K7MDL2/RF-Power-Meter-V1/Pictures/Teensy 4.1 Wattmeter and Band Decoder Combo Build PinOut Chart.jpg

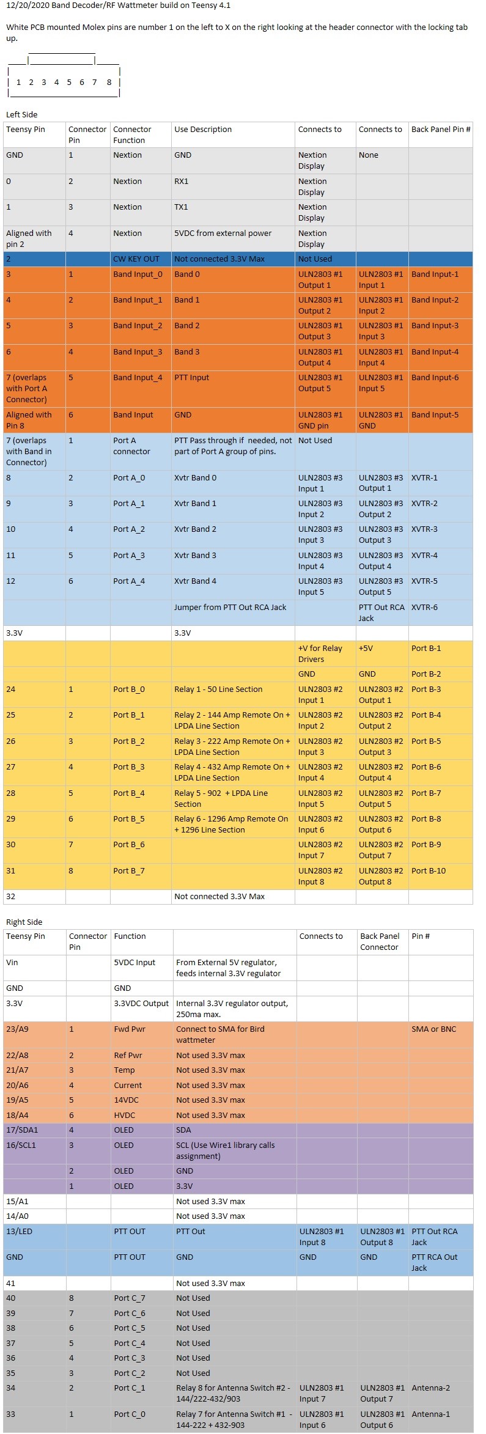
Pictures/Teensy 4.1 Wattmeter and Band Decoder Combo Build PinOut Chart.jpg
