K7MDL2/RF-Power-Meter-V1/Pictures/Teensy 4.1 Band Decoder-Wattmeter CPU board connectorization.jpg

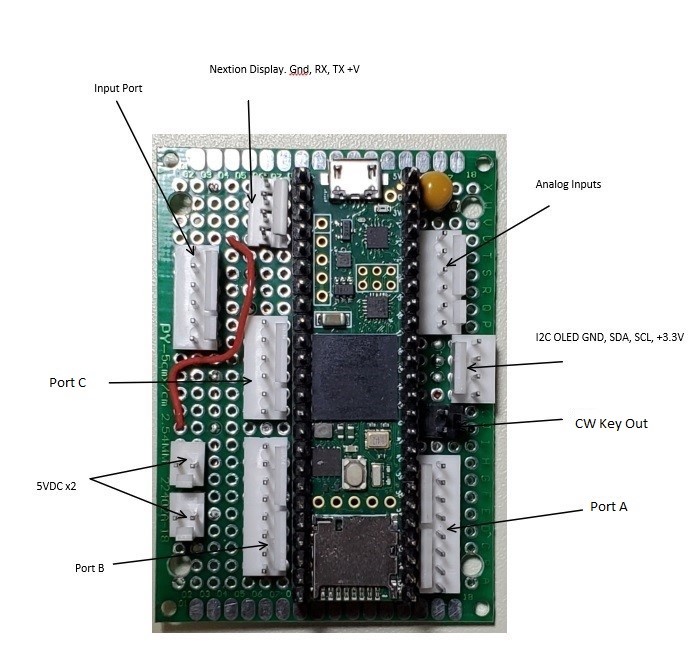
Pictures/Teensy 4.1 Band Decoder-Wattmeter CPU board connectorization.jpg
