K7MDL2/RF-Power-Meter-V1/RF_Wattmeter_Teensy41_PCB_V1/Docs/Teensy 4.1 RF Wattmeter and Band Decoder Project.pptx

## HF-10GHz RF Wattmeter & Band Decoder DRAFT 4/11/2022

By Mike Lewis, K7MDL
Use surplus dual-directional couplers for accurate power measurements using PSoc5LP or Arduino CPU local, or remote over ethernet

## Slide 2

RF Wattmeter portion

RF power forward and reflected
Calculate SWR
Option to output a voltage proportional to SWR for amplifier high SWR protection
Operate either remote over ethernet or local via USB
Operate headless or with a small OLED or a 2.4” or 3.5” Nextion intelligent display
Nextion display has several pages include a SWR chart and calibration, settings
Optional Python Desktop app to monitor power., voltage, current and temp.
Can also change bands and control a headless Arduino Rotator

## Slide 3

Hardware

Custom PCB designed for RFI resistance and no wires (antennas!), and board edge connectors.
ADL5519 dual 10GHz rated log power detector module from SV1AFN
Has about a 60dB usable range
ADS1115 4 cha 16bit ADC with onboard precision voltage refence and programmable PGA
Common online part
Front panel
Power switch and LED
Ethernet jack
Optional displays
Host USB2 port (future use)
Teensy USB connector
Input port on DB9 female connector using Opto-Couplers
6x lines for band selection along
PTT input line
Output Ports on Stacked female D-Sub 15 pin connectors, uses Opto-Couplers
Port A - 8-lines, PTT1 output, low current 12V
Port B - 8-lines, PTT2 output, low current 12V
2 separate PTT outputs, PTT1 and PTT2
Both tied together in software today, can be separated for sequencing with minor coding
One on each output port connector
PTT1 is also presented on a RCA jack
12V powered via coaxial DC power jack

## Slide 4

PCB features

Sized to slides into a common metal case from online
Choice of 2 displays, if any used
PCB designed to be RFI resistant.
Opto-Couplers on all input and output ports
Very short lines from the connectors to minimize RF radiation inside the box
Only wires are from the PCB to a display if used, all are filtered
Input lines to optocoupler bypassed
12V Power and Display power lines filtered
OLED i2c SCL an SDA data lines are also filtered
Choice of 12V to 5V power – 7805 or DC-DC converters such as LC78_05-3.0, or isolated converters
Pico fuse soldered in.
Diode reverse polarity protection
Mounting holes if slide-in case not used.
Extra mounting holes in middle for mounting daughter cards on standoffs for future stuff
2 pin connector on the switched 12V for optional external watchdog power interrupt
2x Watchdog output lines (WD1 and WD2)
Using Teensy 4 internal watchdog timer that can also trigger one the 2 WD lines
12V and %v aux power connectors
4x analog sensor inputs with voltage dividers or current limit resistors.
Software labels set to assume one is HV (high voltage) such as 28 or 50V
1 input can be set up to measure PCB 12V or an external voltage
1 is current
1 is wired to the ADL5519 onboard temp sensor.
Could be used for temp correction for even greater accuracy

## Slide 5

Programmable

Highly flexible configuration using the desktop app
BCD, 1 of 8, or custom pattern modes for input and output ports
Custom patterns allow for mixing devices such as
Transverters
Remote amp enable
Antenna switches
RF detector coax switch for coupler selection
PTT input and output polarity selection
PTT can be routed to any output put port or ports
enables PTT to specific amp
enable specific transverter
N1MM OTRSP serial control for CW, T/R and band select
2 point RF coupler calibration
Measure with a high and low power to compute slope and intercept points.
10 bands today – each has cal data and custom patterns
Can display microwave band labels (10G, 2.4G, 1296, 24G)

## Slide 6

K7MDL2/RF-Power-Meter-V1: RF wattmeter and Band Decoder on Arduino or PSoC5 modules with Python desktop monitoring and control app. Remote operation via USB Serial or Ethernet (new). (github.com) (https://github.com/K7MDL2/RF-Power-Meter-V1)
