K7MDL2/RF-Power-Meter-V1/Pictures/3.5in RF Wattmeter with Band Decoder.jpg

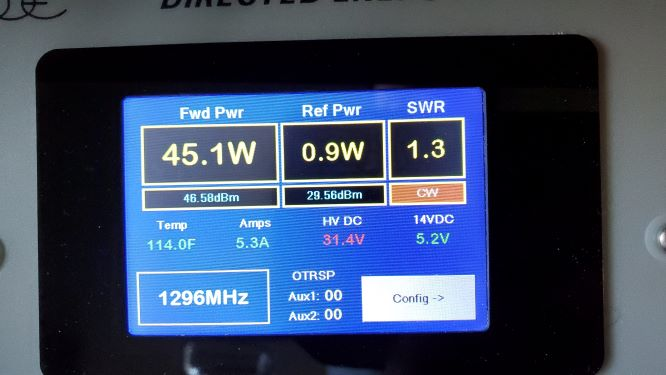
Pictures/3.5in RF Wattmeter with Band Decoder.jpg
