K7MDL2/RF-Power-Meter-V1/Pictures/1296MHz Amplifier Front Panel with OLED RF Wattmeter Mounted.jpg

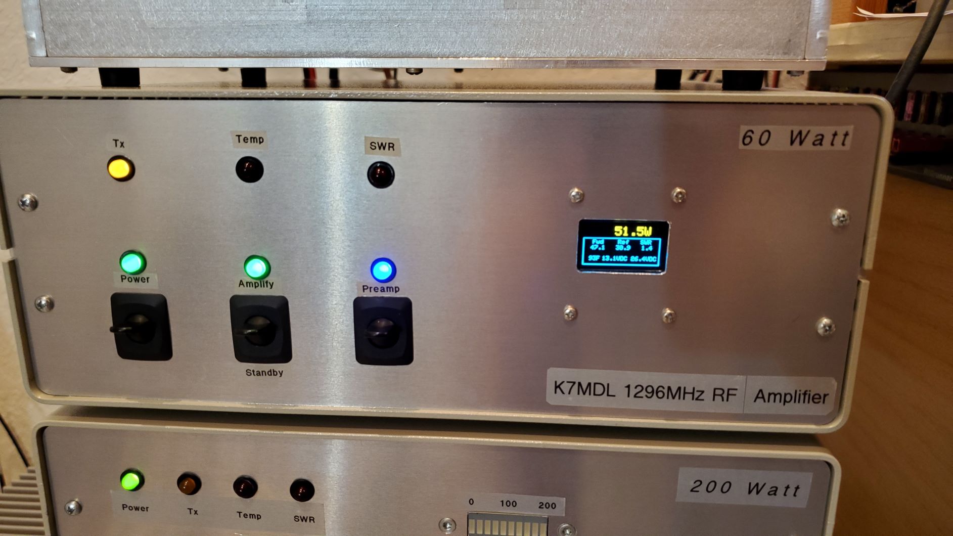
Pictures/1296MHz Amplifier Front Panel with OLED RF Wattmeter Mounted.jpg
