K7MDL2/RF-Power-Meter-V1/Pictures/BandDecoderWattmeter_PCB_V1_Bottom.jpg

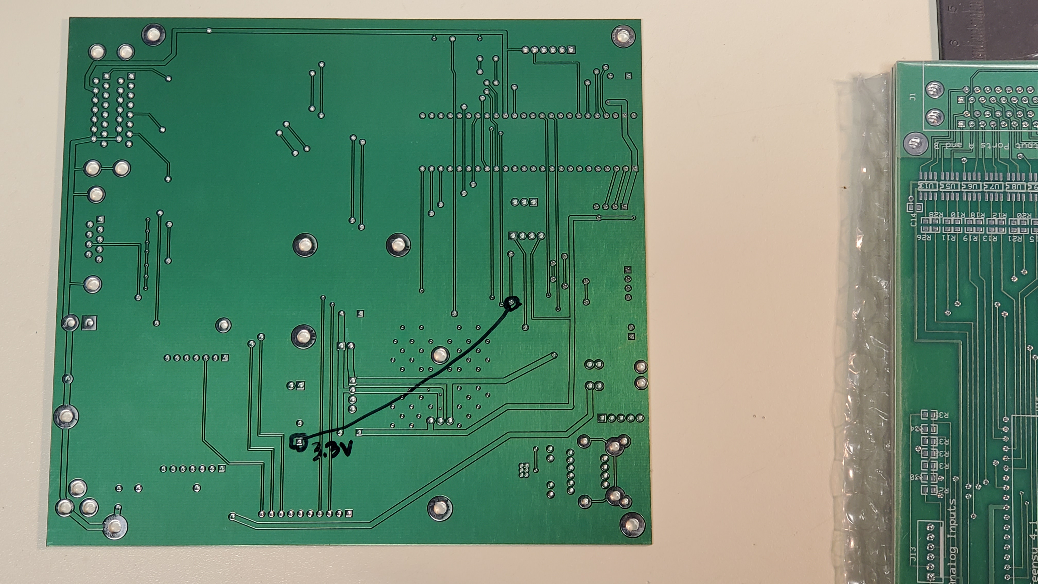
Pictures/BandDecoderWattmeter_PCB_V1_Bottom.jpg
