K7MDL2/RF-Power-Meter-V1/Pictures/Desktop Configuration Page Screen Shot.JPG

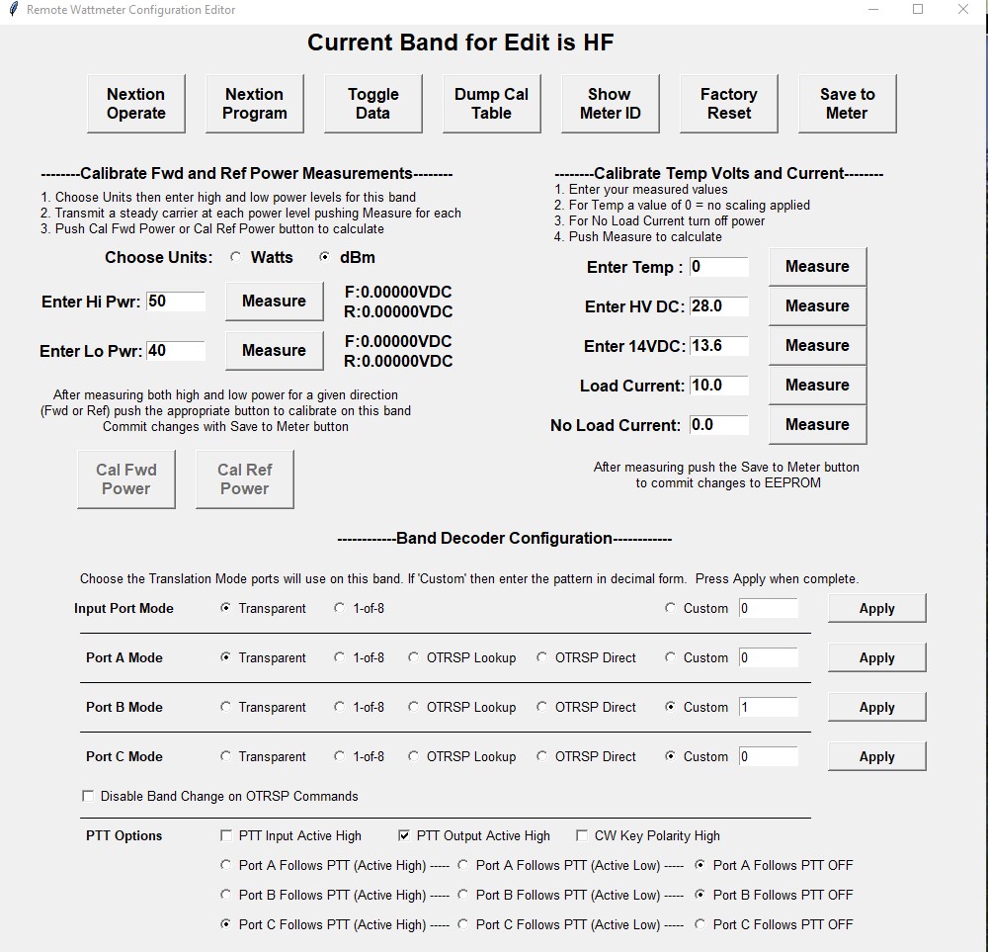
Pictures/Desktop Configuration Page Screen Shot.JPG
