K7MDL2/RF-Power-Meter-V1/Pictures/Edit Meter Table Screen Shot.JPG

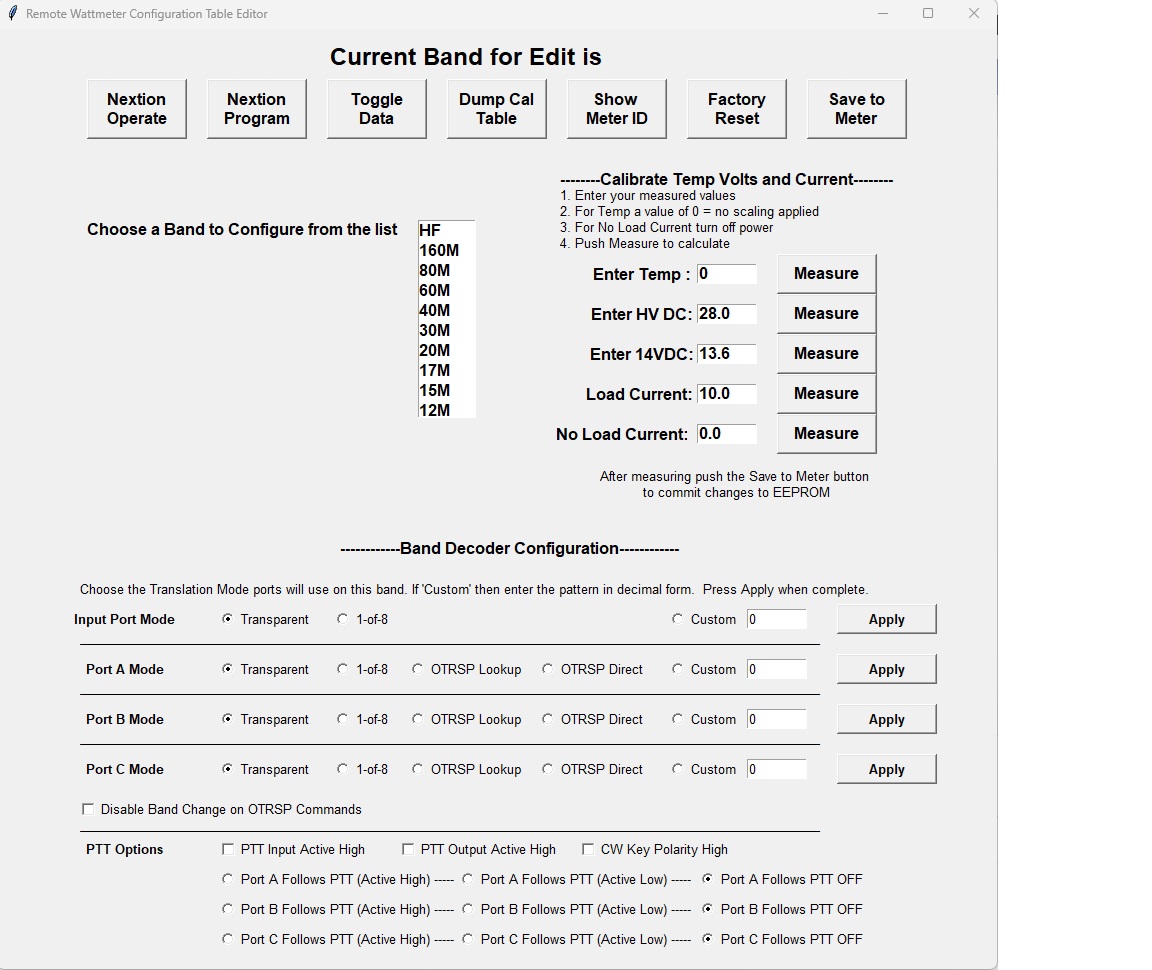
Pictures/Edit Meter Table Screen Shot.JPG
