K7MDL2/RF-Power-Meter-V1/Pictures/Finished Rotor  Controller Side.jpg

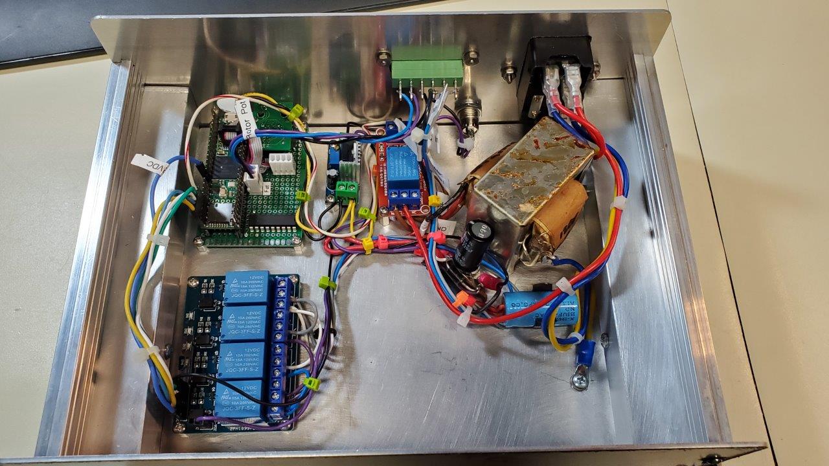
Pictures/Finished Rotor Controller Side.jpg
