K7MDL2/RF-Power-Meter-V1/Pictures/K7MDL 2.4 inch PSoC LCD Main Page.jpg

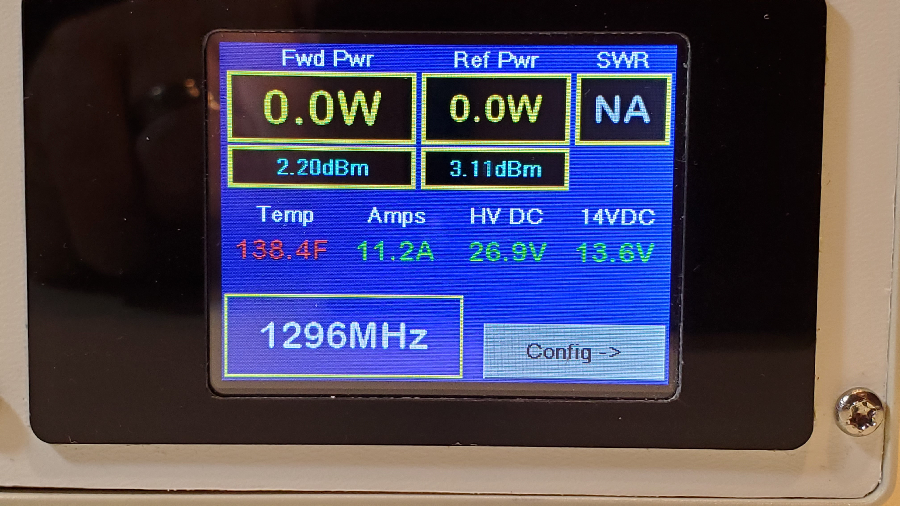
Pictures/K7MDL 2.4 inch PSoC LCD Main Page.jpg
