K7MDL2/RF-Power-Meter-V1/Pictures/K7MDL 2.4inch PSoC RF Meter.jpg

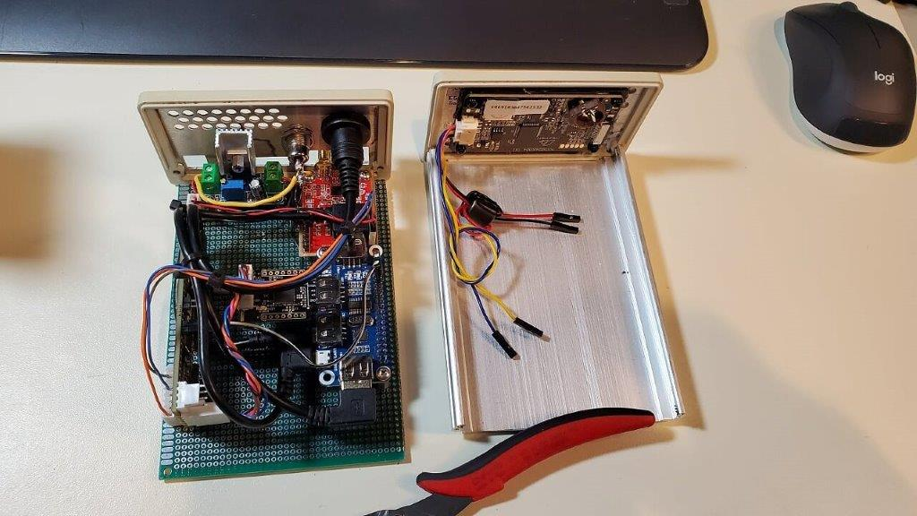
Pictures/K7MDL 2.4inch PSoC RF Meter.jpg
