K7MDL2/RF-Power-Meter-V1/Pictures/K7MDL RF Power Detector.jpg

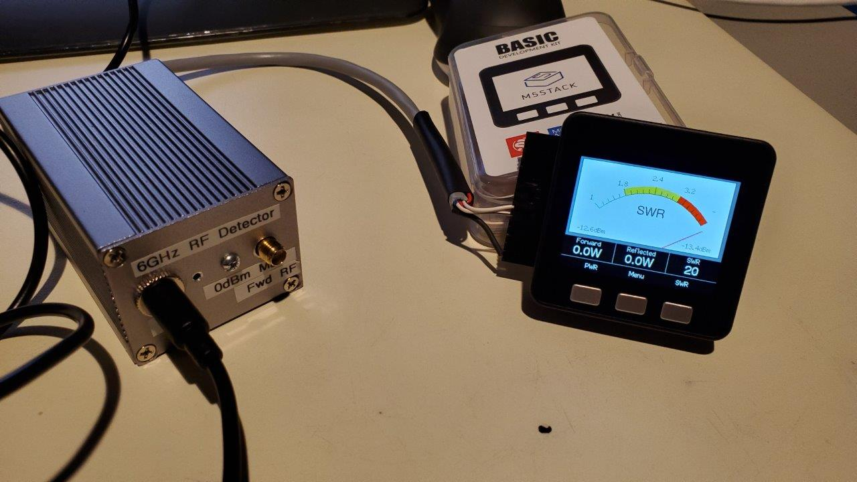
Pictures/K7MDL RF Power Detector.jpg
