K7MDL2/RF-Power-Meter-V1/Pictures/New May 2024  Edit Meter Config Screen Shot.JPG

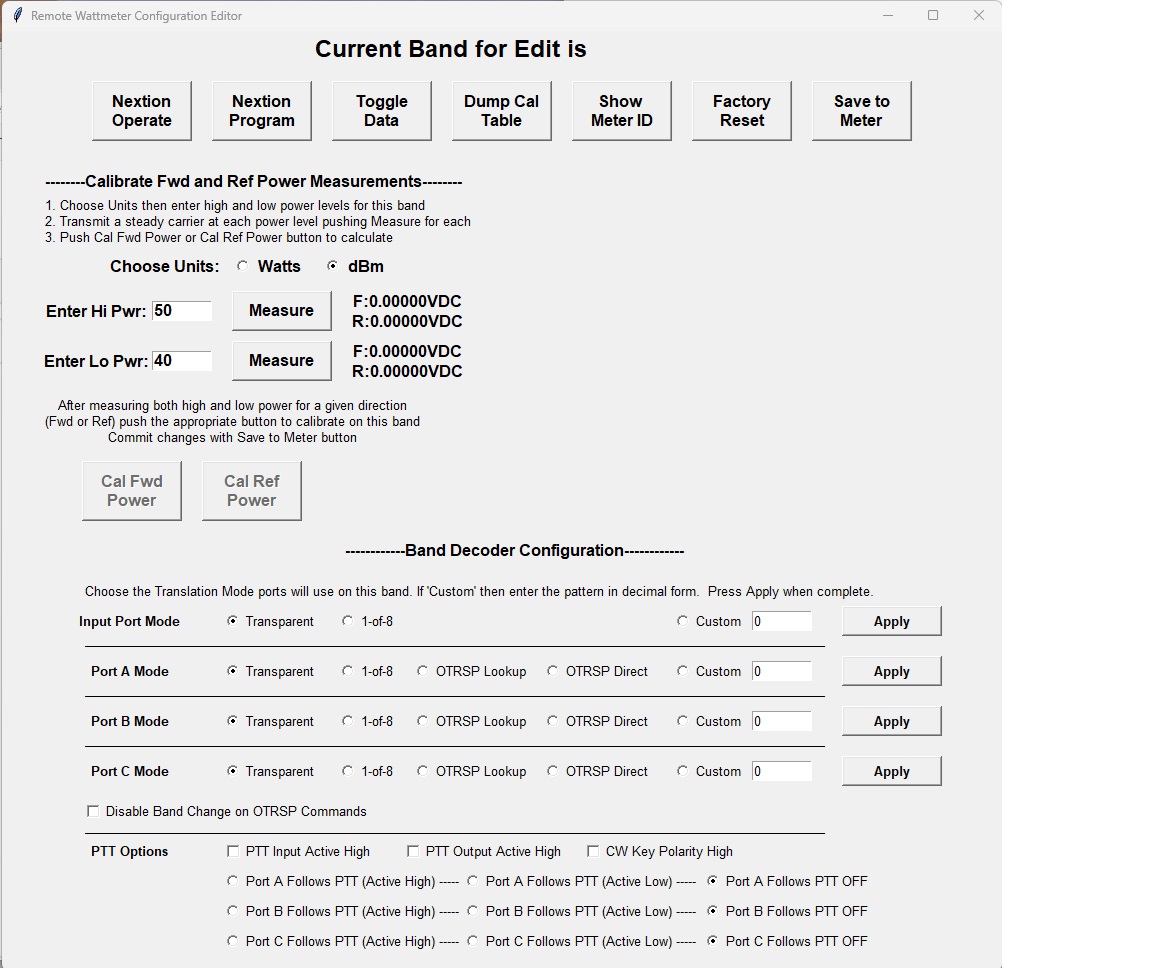
Pictures/New May 2024 Edit Meter Config Screen Shot.JPG
