K7MDL2/RF-Power-Meter-V1/Pictures/OLED Power and Band Decoder Combo screen.jpg

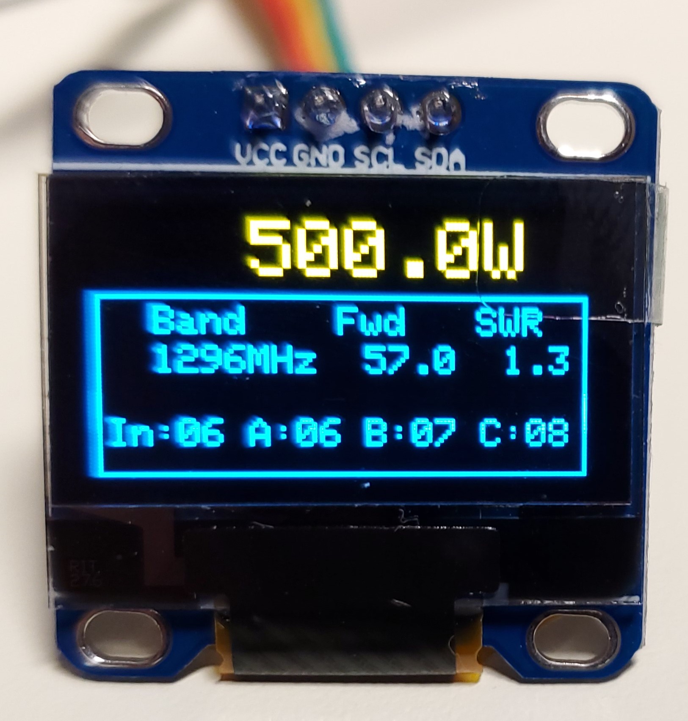
Pictures/OLED Power and Band Decoder Combo screen.jpg
