K7MDL2/RF-Power-Meter-V1/Pictures/Remote Band Decoder Front Panel.jpg

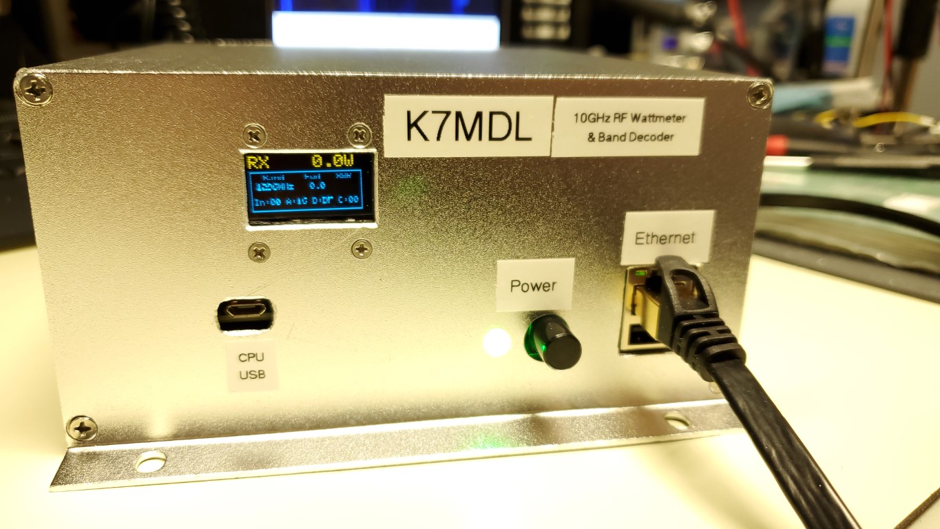
Pictures/Remote Band Decoder Front Panel.jpg
