K7MDL2/RF-Power-Meter-V1/Pictures/Remote Band Decoder Rear Panel.jpg

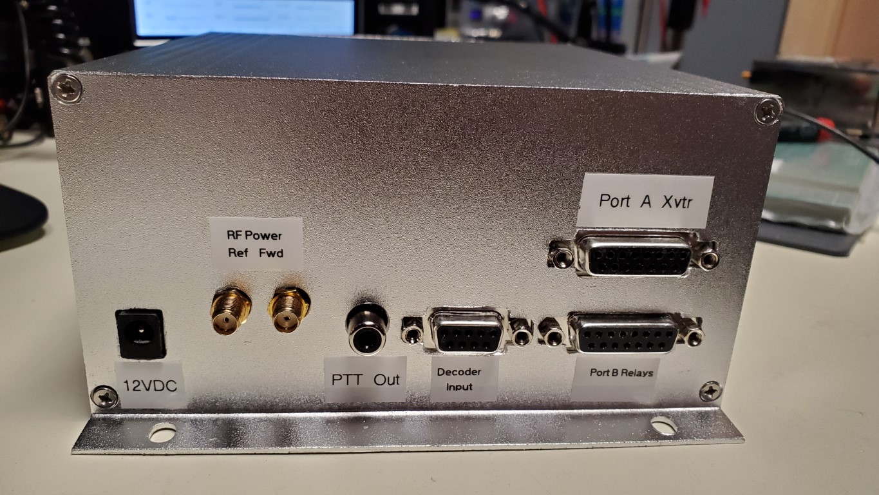
Pictures/Remote Band Decoder Rear Panel.jpg
