K7MDL2/RF-Power-Meter-V1/RF_Meter_PSoC5LP/Amp and Antenna Selection Page.JPG

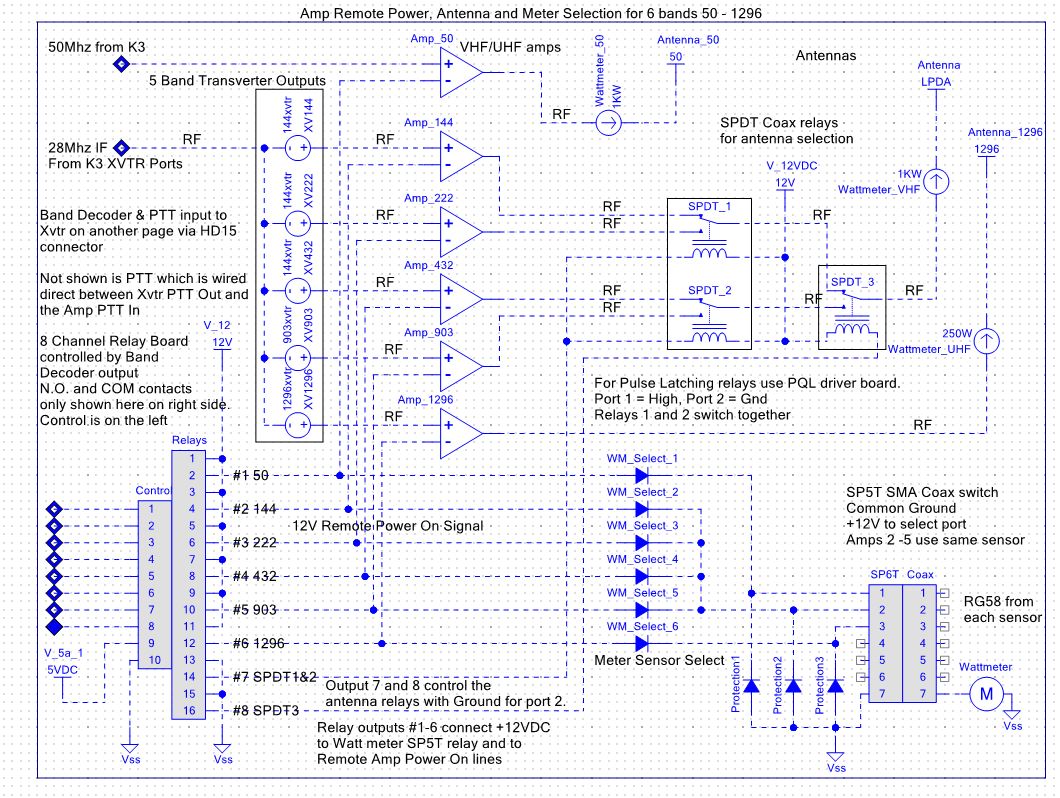
RF_Meter_PSoC5LP/Amp and Antenna Selection Page.JPG
