K7MDL2/RF-Power-Meter-V1/RF_Meter_PSoC5LP/Band Decoder Page.JPG

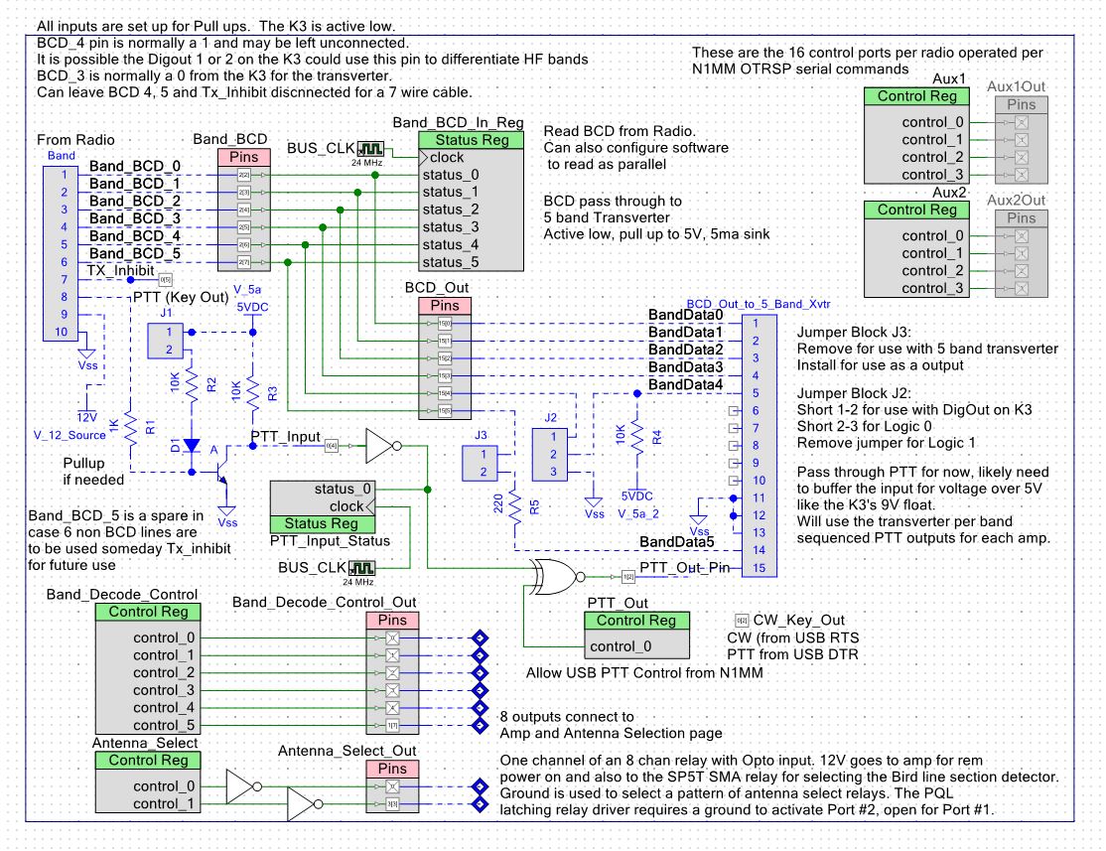
RF_Meter_PSoC5LP/Band Decoder Page.JPG
