K7MDL2/RF-Power-Meter-V1/RF_Meter_PSoC5LP/SWR Voltage Output for Amps.JPG

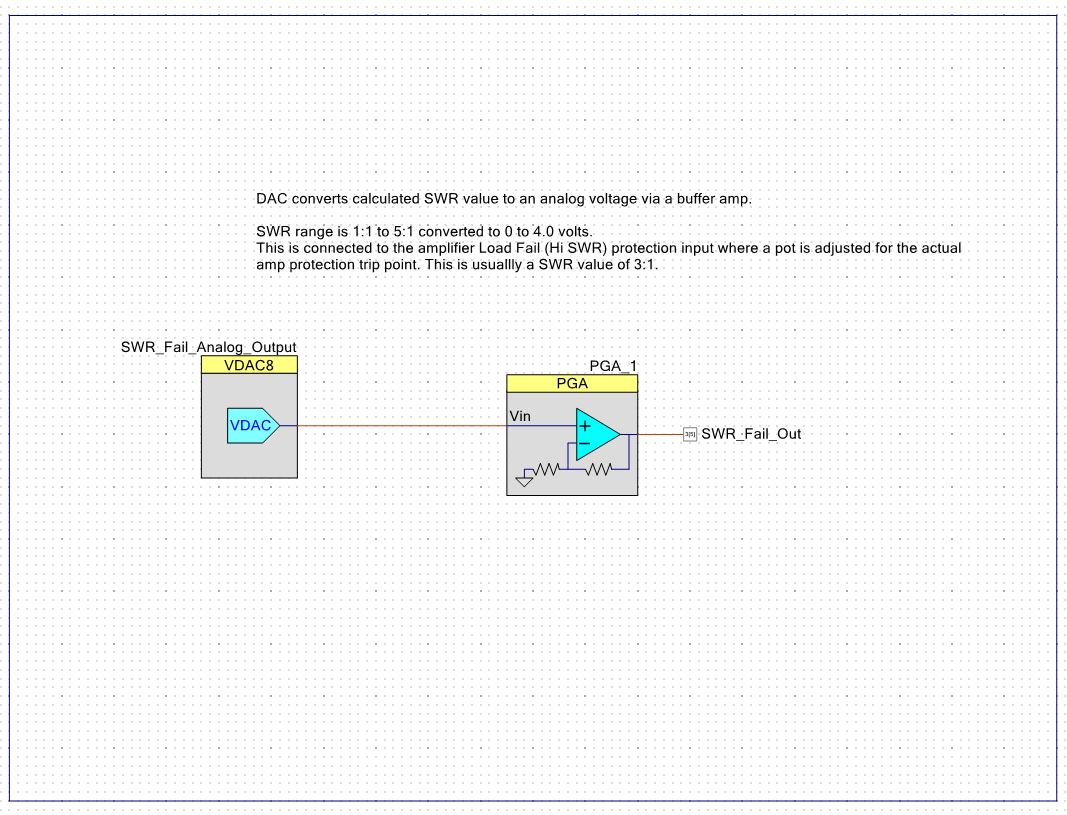
RF_Meter_PSoC5LP/SWR Voltage Output for Amps.JPG
