K7MDL2/RF-Power-Meter-V1/RF_Wattmeter_Teensy41_PCB_V1/PCB_Files/PowerMeter_BandDecoder_V1_Schematic_IO.bmp

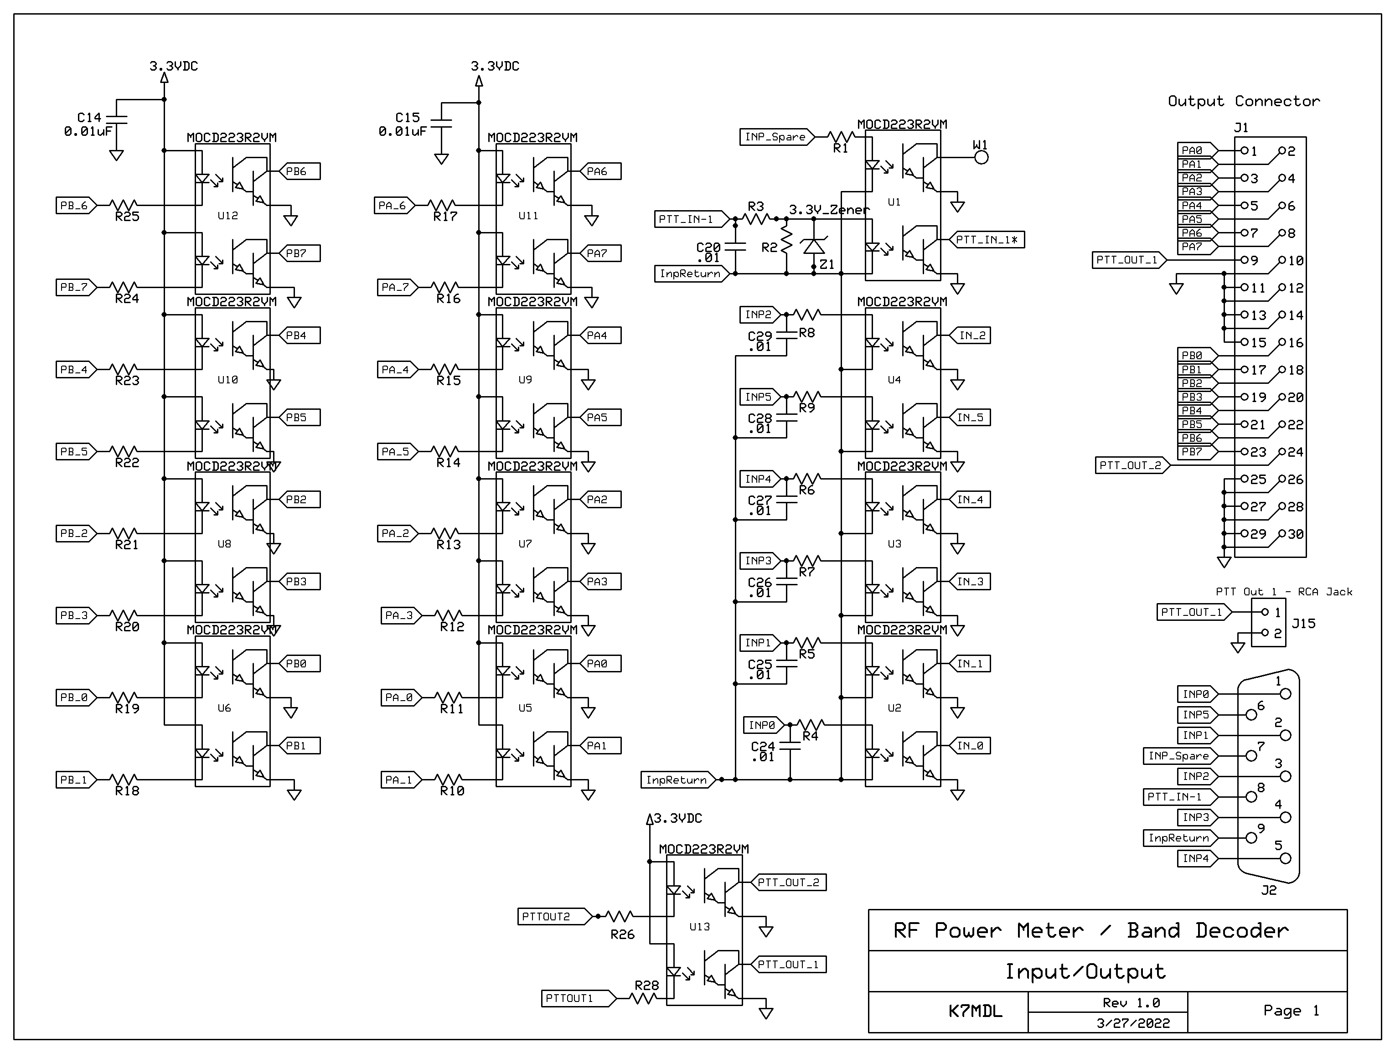
RF_Wattmeter_Teensy41_PCB_V1/PCB_Files/PowerMeter_BandDecoder_V1_Schematic_IO.bmp
