K7MDL2/RF-Power-Meter-V1/RF_Wattmeter_Teensy41_PCB_V1/PCB_Files/PowerMeter_PCBv.02.bmp

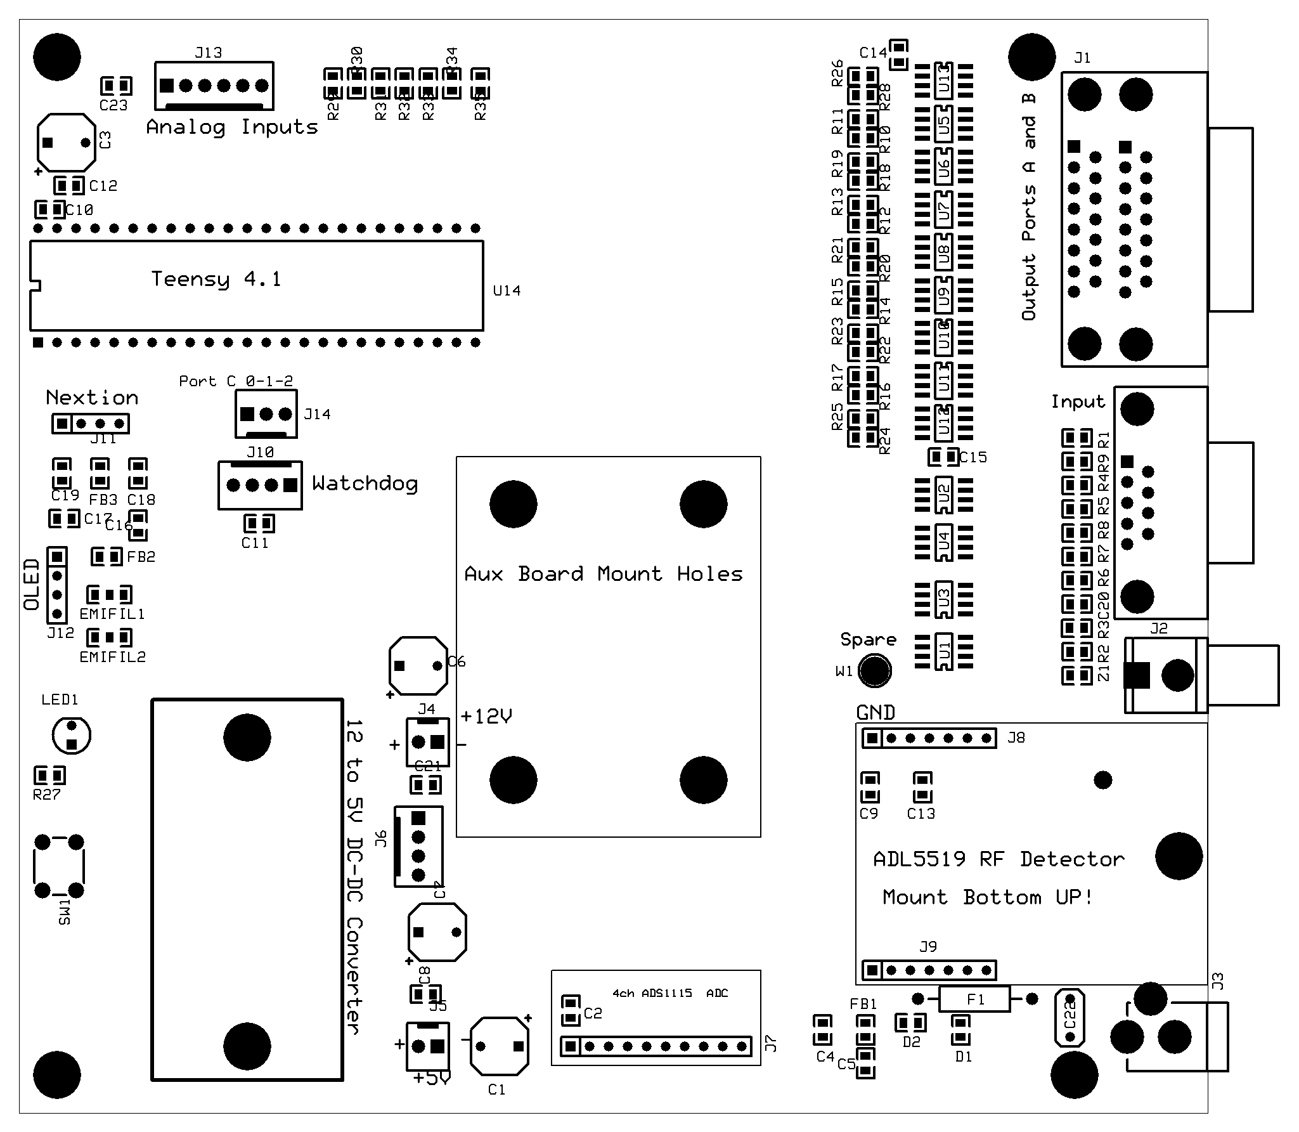
RF_Wattmeter_Teensy41_PCB_V1/PCB_Files/PowerMeter_PCBv.02.bmp
