K7MDL2/RF-Power-Meter-V1/(threads)

Thread 1 (2020-04-28):

Add Wi-Fi Data Connection

K7MDL2, 2020-04-28:

K7MDL2, 2020-05-10:
M5Stack uses the ESP32 CPU and I believe the 2nd ADC is taken over by the Wi-Fi features.  This makes it necessary to use an external Wi-Fi connection, ethernet, and ADC.

IF you have Wi-Fi remote monitoring it usually does not need a local graphics screen so will move this feature to a headless version platform choice.   Having both makes sense if the cost to build these was high to build/buy only 1.  These are cheap though.

K7MDL2, 2022-10-28:
Current versions on Teensy have wired ethernet.   Can plug into an inexpensive access point for wireless.

Closed 2022-10-28.

Thread 2 (2020-04-28):

Allow headless operation

K7MDL2, 2020-04-28:
Remove the requirement to have a local screen attached for full operation.   Ideally all config needed should be by a serial connection issuing commands to the Arduino.  A much easier way is to use a USB connection to change values in the code and reload.  In any case, once operational the remote commands need to replace the buttons in normal operations.
Not dependent on wireless capability but should work the same on both wireless and USB.

K7MDL2, 2020-05-10:
Completed in RF_Nano_Headless.ini and matching protocol and MeterID changes in the Desktop UI app.  All buttons nd screen dependencies are gone, all operations plus CPU reset are now available by remote commands.  Can also monitor multiple meters

Closed 2020-05-10.

Thread 6 (2020-05-10):

Redesign the Desktop UI for multiple meter support, revised button functions

K7MDL2, 2020-05-10:
With the headless version now available, all commands previously available via buttons are now remote serial port commands.  Additionally CPU reset, Cal table dump, and upload a cal value are added.
Meter Rate +/- is removed from the meter
New controls needed:
1. Power level data stream out from meter on/off (switch in meter)
2. Overwrite meter EEPROM with Factory default values
3. meter CPU reset
4. Dump Calibration table from meter
5. Upload specific meter cal value
6. Choose which meters and band buttons to display
7. New labels for band buttons (may want to change Arduino to fixed numerical band label, save EEPROM and translate number to friendly description on the desktop side.

K7MDL2, 2024-04-23:
Mutiple meter monitoring was envisioned as ability to have multiple panes in a single window, or ability to run separate apps.  Each meter would have a unique meterid to keep the data sperate.  Ethernet was added later.
In April 2024 I finally had need to run separate band decoder boards over ethernet.  I gave each decoder board a unique meter id and ip address.  Despite each desktop app configured for only 1 address (same ports), data from both meterids was received.  I figured the IP address+port combo would be unique.  Seems not.  I had to change o a unique port number as well.  As of April 20, 2024 you can now run 2 separate apps.  Additionally, a new variable will write 'NA' into the Fwd, Ref, and SWR fields if not using the wattmeter portion.  One of my decodes is a stripped-down board just to monitor 14, 28, temp and act as a band decoder.  No displays, no ADL5519 RF detector.  Left out all parts not required.  I also disabled the WSJT-X UDP code as this is not needed when you have a radio band decoder connection.  It can also cause unexpected band changes when running multiple WSJT-X instances for multiple radios.

K7MDL2, 2024-04-23:
Still need to enable multiple units to display within the same app screen.

Thread 8 (2020-07-27):

Add OTRSP Protocol support for N1MM Antenna Switch Integration and Band decode output

K7MDL2, 2020-07-27:
Allows N1MM+ logger to control radio and transverter and antenna selection by interpreting the OTRSP serial port messages from N1MM (configure->antennas tab) and converting to GPIO pin outputs.  Also handle PTT routing with Key in port and several PTT outputs.  Use SPI or I2C IO drivers for higher voltage and higher current handling.

K7MDL2, 2020-07-28:
N1MM can output a value 0-15 based on antenna rules. It is sent via serial port using the OTRSP protocol.  This change uses UART2 to receive and parse the message and output the the number as BCD on  4 pins of Port 0.  Easily changed to parallel ports if needed.  There is Radio number in the message (as 1 or 2), this code is only acting on Radio 1.  A second Port could easily be enabled for Radio 2.

Closed 2020-07-28.

Thread 10 (2022-03-29):

Design a PCB that is RFI resistant for remote location close to high power antennas

K7MDL2, 2022-03-29:
A version built on proto PCB with lots of short wire connection in a plastic case, located within 25ft of the several VHF antennas often locks up when transmitting with high power levels like 150W to 500W.  Several remedies have help a bit, but it is time to create a PCB with particular attention to RFI resistance,  To that end I have a nearly completed PCB waiting for parts to arrive and do a part fit verification before ordering boards.

K7MDL2, 2022-04-10:
Created an optocoupler based board with only ethernet cable inside on 3/31/2022. Ordered 8 boards and built 1 of them.    Made several tweaks to the board as I built the first one including routing the USB host and ethernet cables wired onto the board and fixed a missing 3.3V trace.

Closed 2022-04-12.

Thread 11 (2022-10-28):

Configurable IP Addresses

K7MDL2, 2022-10-28:
Currently the desktop target IP is hard coded.  Change this to store the IP address in EEPROM.
Add new remote command to remote store the address
Add new remote command to read it by remote app.
Read and use the address on each bootup and use if Enet enabled.

K7MDL2, 2022-11-02:
Code added to store last 2 bytes into EEPROM.  There are 2 IP Addresses.  Destination for reporting and the units own assigned static IP (can be set for DHCP also).   All are defaulted to $define values which are copied to variables and stored in EEPROM.  It is possible to use the standard remote command process to update the last 2 bytes.  The 3rd byte is common to both unit and remote, so this implies they are on the same subnet of 255 addresses.  This is only because I had 3 unused bytes left in the 3rd row of EEPROM without major relocation and wipe and reload of existing field units EEPROM which impacts stored calibration data.

Next step is to test it which I have not had a chance to do yet.

Thread 12 (2022-11-28):

HF power meter

rembulan, 2022-11-28:
can I ask for HF calibration and power setting, in my country legal limit is 1500w. it must wonderful if I program the max limit and when the power pass max limit there is some warning in the screen
thank You,
Anton

K7MDL2, 2022-11-30:
Being VHF focused with all my big amps are on 50Mhz or higher, I used the HF position as a way to tell the band decoder to switch everything to the equivalent of OFF.  In my remote transverter/amp setup, they are all outside the house.  The band decoder sets the correct band on the transverter, powers on the correct amp, selects the correct bi-directional coupler SM switches, sets the correct antenna RF Coax switch lineup, and passes through PTT.  HF, or "Band Slot 0" I use to set all that to the safest state (OFF or open).

In theory you can put in cal values and all should work but I likely have some code to zero displays on Band 0.

I do have an external HF amp and would like to revisit how Band 0 is handled to be useful for HF readings.

That said, you can rename any band label.  So you can have several HF bands if you like, or just 1.  If using manual band selection on the meter no problem, it will cycle though all slots and display the name you program in.  IF using band decoder input cable, then you need to send a band value other than all 1s or all 0s.  Slot 0, the "HF" label today is all zeros.

The band decoder can have any input pattern you like.  Can be BCD format, just one of up to 6 input lines, or any random pattern you can send to it.  You could use a SP6T rotary switch and active 1 line of the 6 lines to get 6 bands, all can be renamed HF or more likely 20M, 30M,, 40M, etc.     Using a BCD type coding gets you more bands with fewer input lines.

The point here is if you can control the band input pattern sent to the decoder, you can rename any band slot as you like.

The 2nd ask you made is for a High RF power alert on any band, set per band.  I can see this would be handy.  Adding the new threshold control and alert indicator requires some UI rework to squeeze it in but can be done.   You can skip all of this if you only use the desktop app.  Then all changes are in the Python UI including band button labels.  No Band input cable required.  An easy temporary code workaround is to take over an existing alarm threshold control and alert indicator such as 13VDC and make it a global high power alarm.  Just substitute the Fwd Power value for the 13VDC value and rename the UI labels.

Thank you for the suggestions.  These days I am working mostly on my Teensy 4 SDR but will consider this feature request when I come back around to the RF wattmeter code again.

K7MDL2, 2024-04-28:
Will be revisiting the HF support situation.

rembulan, 2024-04-29:
You make Christmas come earlier this year to me, Thank You

K7MDL2, 2024-05-07:
Tonight I made changes to support 21 bands and preprogrammed the names for each 160M though 3cm with default Band input and Port A, B and C output patterns based on my K3 band decoder output.  THE first (index 0) was meant to be a catchall when an undefined input pattern match is encountered.  Probably needs more work.  The default calibration values are just examples.  Each band must be calibrated as usual.   Each time your set RESET_EEPROM =1 it wipes all stored EEPROM values and you must start over.  It is helpful to dump the cal table and copy and paste the table text to a file.  You can put those values in the default band table also.   Be sure to set RESET_EEPROM value back to 0 after the first boot or you will overwrite any new config/cal changes you make!  You need to reset EEPROM when making changes to the Band table size or layout, or want to overwrite the cal/config values with hard coded values.

The HF change was fairly simple, increased the NUM_BANDS and populated the structure with more bands by copying and editing the existing ones.  IN my K3 I changed KIO3 to HF-TRN and wired up DigOUt0 and DigOut1 to use all 6 input pins.  This results in a unique pattern on the input for every bang HF and VHF.  IF frequency comes in serially then that is easier.

The desktop App will need more work.  It has a limited number of buttons for a select number of VHF bands today.  The button labels are hard coded text. In the Python code for each button calls code which sends a band index number associated with that button.  It is not hard to change the button text and band number to other bands.  If your radio is controlling the decoder then the buttons are not required.  You can instead edit the band table structure for each band for the proper values of Band_Input, Port A, B and C outputs and then in the top of the .ino, set RESET_EEPROM to 1 and send up to the Teensy (set for Triple Serial).  Change bands with the radio (or simulate with a switch or wire jumpers on a breadboard) and for each band the Desktop App will display the correct text.  For each band you can then Edit the Config in the UI to calibrate and change any Ports patterns, PTT polarity, etc.

RE: Hi Amplifier Ouput Power Alarm: The Nextion touch screen flags thresholds for Voltage, Temp, and Current.  There is no threshold today for max power.  In a special 1296 Amplifier config I calculate SWR and output a 0 - 4.0VDC signal intended for an amplifier sequencer board HI SWR shutdown protection input.  The same approach could be used for trigger something or even set a port connected to TxInhibit.  Special UI code would need to be added.  This type limit is normally a function of the amplifier if they have a UI. You can add Python UI code to do anything you need.  It is not something I see getting around to anytime soon.  Changing the Nextion screen and related code is tedious.  In the future I would replace the Nextion with a graphics screen like the 4.3" or 7" I use in my Teensy SDR project.

K7MDL2, 2024-05-07:
Next steps are to test this for a while and ponder what to do about the band select button limitations.  It is most convenient to use the UI to call up a specific band to enter the config and cal and force a band change in case the serial or wired inputs are not connected or correct yet. As mentioned, you can edit the band table defaults as a workaround.

K7MDL2, 2024-05-08:
I created a new Edit Meter Table page and added support in the firmware and Desktop App (only in the Desktop_App_190 version for testing).  Now supports 20 bands 160M though 3cm (10GHz).  Nothing fancy.

The new "Edit Meter Table" page has scrolling list box where you can select any one band and that will be made active allowing you to edit the Decoder IO patterns desired.  This is useful when you first setup a new wired or serial input.  You need a way to make the band current to be able to edit it before you have a wired config defined, a chicken and the egg scenario.

Also the per band Power Cal/SWR calibration fields are only on the "Edit Meter Config" page.  Will update the main Desktop_App.  Note that you must RESET_EEPROM one time for the new band data in EEPROM, the structure has changed so the EEPROM must be initialized.

Any Feedback is welcome.

rembulan, 2024-08-12:
its very nice feautures I really like to try it with real hardware but using teensy is not a good thing for me.
far better if its use raspberry pi pico 2

Closed 2025-04-05.

Thread 13 (2024-04-28):

Port Desktop Python App to Linux

K7MDL2, 2024-04-28:
Enable the Desktop app to run on a dedicated RPi machine.  An encoder can allow for rotator turning.  I have a few PiHPSDR focused controllers with encoders and switches that can become a dedicated ethernet connected controller.

K7MDL2, 2024-04-28:
Desktop Python app ran on Linux Mint with no changes.  Even sees a serial device.  When changing IP address related data on the target decoder board you need to reset EEPROM then reconfigure and recal.  I think there is a remote command to change the dest and host IPs also.

K7MDL2, 2024-04-28:
Seems to work with no changes required on LinuxMint.  Should work on RPi.

K7MDL2, 2024-05-02:
Seems to work the same on RPi 4B with Bullseye 64bit.

Closed 2024-04-28.

Thread 14 (2024-05-07):

PCB V0.1 errors and May 2024 updated Build Notes

K7MDL2, 2024-05-07:
The first PCB produced had some small trace errors.  The current version files are 0.4 and contain fixes for these and a few small new features like 12V on the Port A and B connectors.

For V0.1

1. The vertical segment 3.3VDC trace from the Teensy to J13 connector pin 1 crosses 2 signals to the Teensy.  Use a sharp knife and cut the 3.3VDC trace in 2 places either side of the horizontal traces.  Pin 1 is likely not ever used.

2. A 3.3VDc trace segment is missing supplying power to the 4 channel ADC (ADS1115) module connector.  Solder a jumper wire between 3.3VDC somewhere on the board and pin 1 on J7.  I found a via near the power supply section for the source.

3. The top and bottom ground planes areas and ground traces passing through them were meant to be "stitched" tying them together using via.  The via were not assigned to GND circuit so in production they are all isolated and thus do nothing.  The ground copper is floating.  I scraped the solder mask away from select ground traces and vias in each area to tie the top and bottom together.

4. Related to #3 above, the vias would also help transfer heat to the bottom of the PCB if they were actually connected properly.  Further, the solder mask should have been left off this area to allow the option of bending a 7805 regulator down to the board and using the board and any metal under it to act as a heat sink.  In practice, I add a heat sink to the regulator tab anyway and install a standoff under the tab & PCB to wick away some heat to the enclosure bottom or PCB support brackets.

5. The PCB was sized to fit a particular affordable aluminum enclosure.  As of May 2024 it is unavailable.  I could not find and exact replacement.  Since most of the hardware is on the back edge, I recommend find a slightly larger case, 7" deep is good.  Mount the PCB back edge to the back of the case (lot of holes to cut!) and on the front of the PCB leave off the power switch, LED, and PCB mounted USB/Enet combo jack.  Instead run wires to front mounted LED and Power Switch.  For the Ethernet jack, I just used the standard Teensy mag jack and ribbon cable that runs to the Teensy 6 pin connector.  I turned the jack upside down and soldered the jack case to the PCB ground plane. facing out to the side where I had lots of room.  In my 2nd build I used a 10" wide x 7" deep Hammond model 1402KV enclosure.  I mounted a 3.5" Nextion touchscreen using a CN milled acrylic bezel on the front panel.  I used a right angle ethernet extension to chassis mount on the back panel.  Same for the USB jack.

K7MDL2, 2024-05-07:
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

K7MDL2, 2024-05-07:
I later added a heat sink tab to the 7805, a chassis enet jack on the back panel, and hex standoffs to support the edges of the ADS1115 and ADL5519 modules.  I use 1 washer on each SMA jack between the back panel and the ADL5519 board.  Ensure you have some clearance around the RC and D-Sub connectors as needed for proper connector seating clearance.  Still to add is a rear panel chassis mounted USB extension for the Teensy.  Really only need this for dev convenience if using ethernet.
