K7MDL2/RF-Power-Meter-V1/RF_Wattmeter_Teensy41_PCB_V1/PCB_Files/PowerMeter_PCBv.02_Top_and_Bottom_Layers.pdf

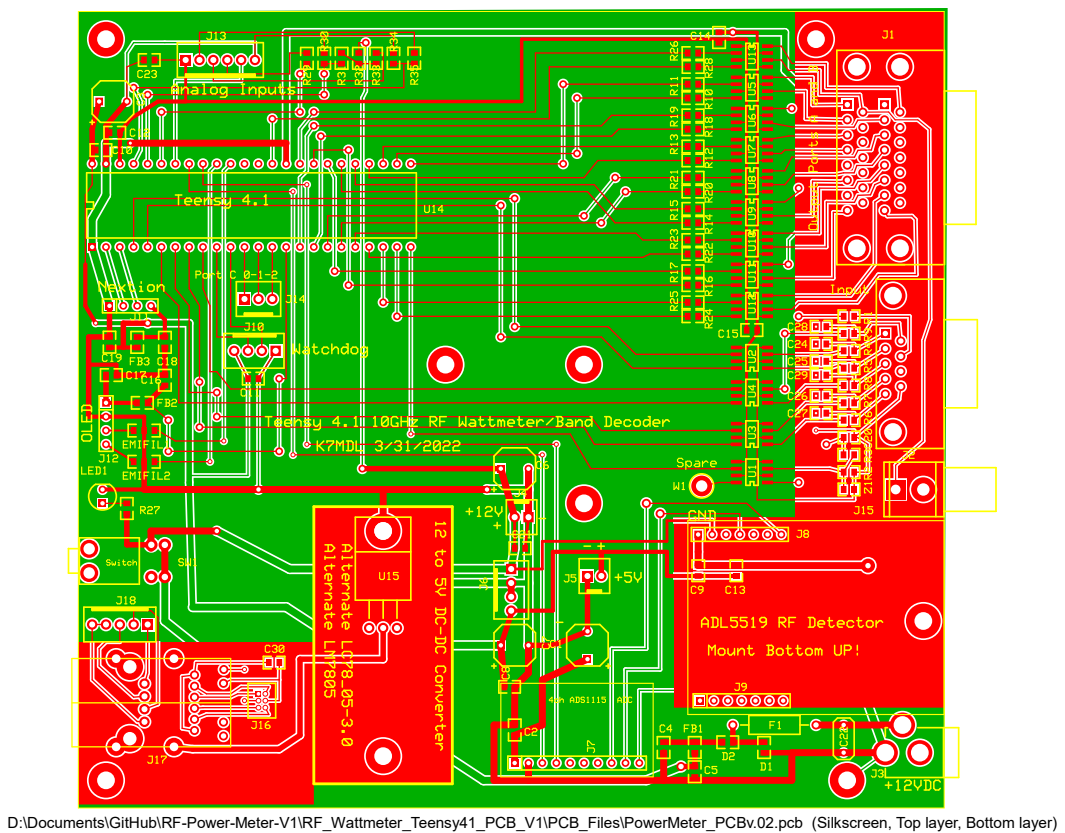
[picture p27: page 1]

D:\Documents\GitHub\RF-Power-Meter-V1\RF_Wattmeter_Teensy41_PCB_V1\PCB_Files\PowerMeter_PCBv.02.pcb (Silkscreen, Top layer, Bottom layer)
