K7MDL2/RF-Power-Meter-V1/RF_Wattmeter_Teensy41_PCB_V1/PCB_Files/PowerMeter_PCBv.04_Top_and_Bottom_Layers.pdf

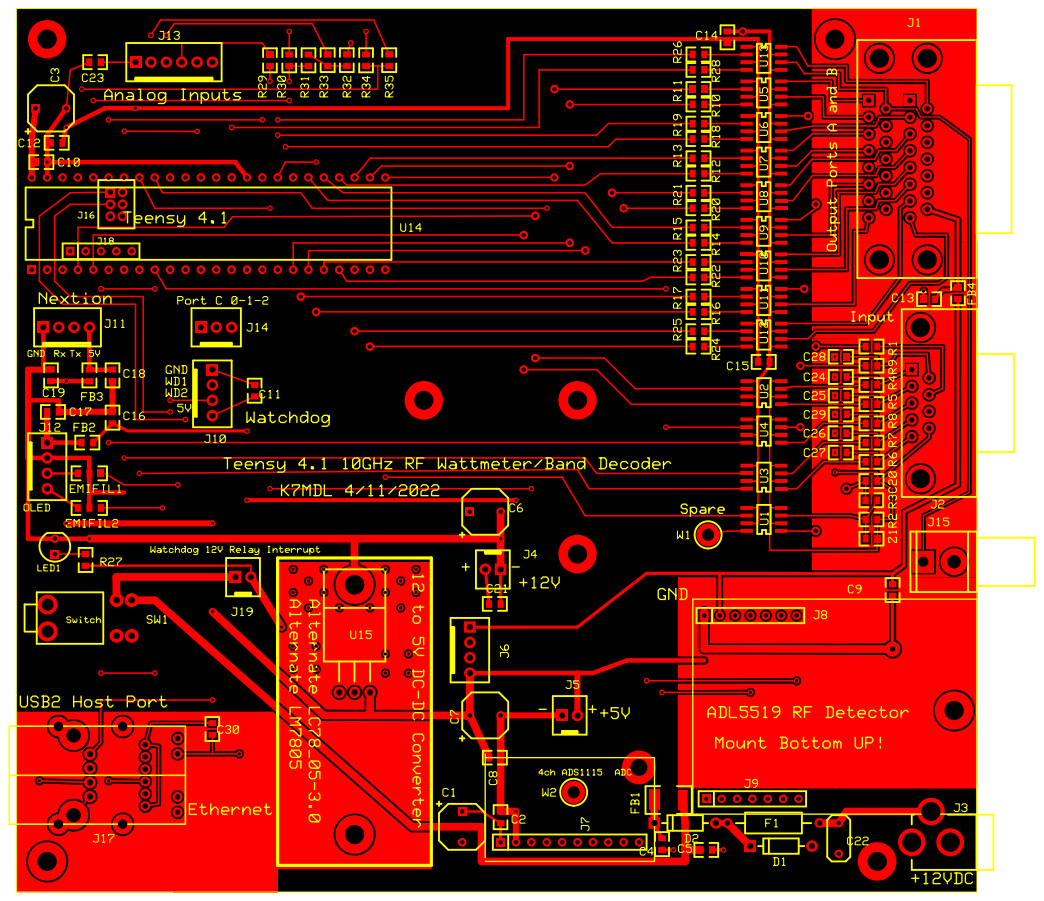
[picture p28: page 1]

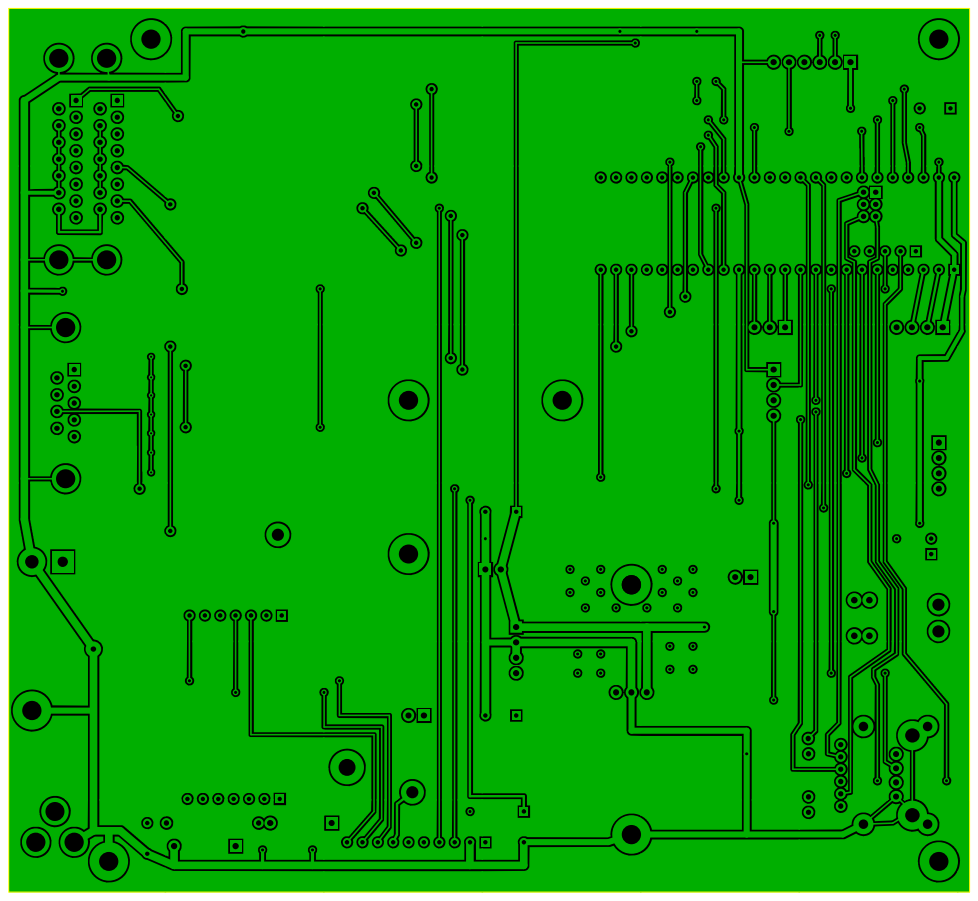
[picture p29: page 2]
