K7MDL2/RF-Power-Meter-V1/(list of files, drawings)

Other design files:
RF_Wattmeter_Teensy41_PCB_V1/PCB_Files/PowerMeter_PCBv.02.pcb
RF_Wattmeter_Teensy41_PCB_V1/PCB_Files/PowerMeter_PCBv.03.pcb
RF_Wattmeter_Teensy41_PCB_V1/PCB_Files/PowerMeter_PCBv.04.pcb
