K7MDL2/RF-Power-Meter-V1/Desktop_App/pyRFPowerMeter.py

# pyRFPowerMeter.py

from threading import Thread, Timer
import time
import socket
import select
import serial
import serial.tools.list_ports as cports
import sys
import tkinter as tk
import tkinter.font as tkFont
from tkinter import FALSE
from tkinter import TRUE
from tkinter import Listbox
from tkinter import SINGLE
from tkinter import END
from tkinter import Scrollbar
from tkinter import VERTICAL
from tkinter import BOTH
from tkinter import OUTSIDE
from tkinter import Menu
from tkinter import StringVar
from tkinter import IntVar
from tkinter import LEFT
from tkinter import RIGHT
from tkinter import ttk
from tkinter.messagebox import showinfo
#from tkinter import *
from tkinter.filedialog import askopenfilename
from tktable import Table
import sys, threading
thread_names = {t.ident: t.name for t in threading.enumerate()}

#for thread_id, frame in sys._current_frames().iteritems():
#   print("Thread %s:" % thread_names.get(thread_id, thread_id))
#   traceback.print_stack(frame)
#    print()

print('__file__={0:<35} | __name__={1:<20} | __package__={2:<20}'.format(__file__,__name__,str(__package__)))

import wsjtx_packets as pywsjtx
import simple_server
import tkinter.messagebox
import socket

PowerMeterVersionNum = "2.8.1"
version_string = "RF Wattmeter Remote\nby K7MDL\nV2.8.1 July 27, 2026"
# pyRFPowerMeter  January 30, 2021
# Author: M. Lewis K7MDL
#
#   Companion Desktop app to montor and control the Arduino or PSoC5 version of the RF Wattmeter.
#
#   See project details on these websites
#   Github Wiki: https://github.com/K7MDL2/RF-Power-Meter-V1/wiki
#   GitHUb project Readme: https://github.com/K7MDL2/RF-Power-Meter-V1
#   K7MDL web site  - PSoC5 version: https://k7mdl2.wixsite.com/k7mdl/rf-wattmeter-on-psoc5lp
#                   - Arduino Version: https://k7mdl2.wixsite.com/k7mdl/arduino-rf-remote-wattmeter
#
#   Works with either the Arduino or PSoC5 versions of RF Wattmeter/Band Decoder/Rotator Controller.  One version may have newer features then teh other but generally this program will
#       be backward compatible anbd new commands will be ignored if not supported.    
#
#   There are some PSoC5 programmable hardware features (digital Mux/deMux and voltage controlled GPIO 
#       port) used to switch the Nextion display (if used) between the CPU and a USB serial line
#       to allow remote upload to the Nextion.  On some hardware builds I used a 4 port USB hub
#       with onboard USB USART TTL converter which is at 3.3V since it was meant for a Raspberry
#       Pi Zero.  
#
#   USB Port usage:
#       Main CPU serial connection to a desktop app (not required if using a local display - helpful for calibration from a PC app like this app)
#       Nextion Programming (only needed if the display is used - can use a temporary connection with a USB UART TTL converter)
#       KitProg programming/debugging board for main CPU (only needed for initial programming or firmware updates later)
#
#   Ethernet usage:
#       This app now supports UDP communication with the RF Meter/band decoder as an alternative the USB Serial (only one used at a time).
#       Configure the static IP and Ports for your network in the #defines below.  This was implemented in its own thread. WSJTX and Serial are the other 2.  
#       The serial thread is stopped and started with the GUI ON/OFF button.  It will turn off on detection of serial port issues.
#       Press the button to restore coms once fixed.  If UDP is chosen at statup instead of a COM port, the serial thread is disabled from startup. 
#       At startup "UDP" will be at the start of the USB comm ports list, choose this to use UDP for meter and decoder control.  

#       This program also supports the K7MDL remote rotator controller over UDP in its own thread.  
#       Use ROTATOR_ENABLE=1 flag defined below to enable this feature to display in the UI and allow the rotor control UDP thread to start.
#       There is a rotator configuration window to set up rotor start point, offset, manual limits (CW and CCW) and up to 10 presets.  
#       The rotator part is very new and still under construction on the Python side.
#
#   KitProg usage (in place of the main board):
#       This program controls an embedded KitProg programmer board version (PSoC5 with fewer IO pins) same as the full size PSoC5LP board. 
#       The programming board may be snapped off the Main CY8CKIT-059 dev module and used 
#       standalone. It has a special bootloader installed that can load a user app. A Bootloader component
#       included in the TopDesign drawing must be enabled and a new target CPU platform selected
#       (-039 variant from the list, the -097 is the main device variant) 
#       The Tools->Bootloader Host utility is used to upload the app program to the bootloader on the 
#       KitProg board. To see the board in the Bootloader Host, unplug the KitProg, hoid the reset button
#       down, plug the KitProg back into the USB cable then let go of the switch.  You can now download.
#       At completion of download, power cycle the Kitprog and your app will run normally thereafter.
#
#   All capabilities are controlled by serial port or UDP commands (an API of sorts) which this App leverages.  Not all commands are used anymore as better
#       commands such as in the calibraton area are preferred. Some commands are yet to be implemented in the GUI.
#    
#   This program reuses a version of the Nextion Arduino library on GitHub partially ported to C by another Github user then further modified.
#       https://github.com/itead/ITEADLIB_Arduino_Nextion
#       
#       Some modifications were needed in the UART area and some likely compiler bugs were found and worked
#       around.  Not all commands are supported by library calls so sprintf + sendcommand() functions are used
#       to send any command.  Sometimes a result is expected and the library functions will collect those.  Not
#       doing so results in some delay or confusion if you are looking for a specific return message (like a get
#       value command stacked behind a status message). 
#      
#   Uses the awesome WSJT-X python decoding package py-WSJTX 
#       https://github.com/bmo/py-wsjtx
#
#   The files are included in this release package. For original py-WSJTX download the files and extract into
#        the same folder where you locate this script.
#           for example this script uses the path to import the module from   
#                   pywsjtx.extra.simple_server.SimpleServer     
#           which is the same as ".\pywsjtx\extra\" on Windows OS so keep these pathname structures in sync

#   Requires the pySerial package to be installed in your Python environment.  
#   If you use pip try the following to install them if needed.
#       pip install pySerial

#  *********************************************************************************************************
#   Usage:  pyRFPowerMeter 
#       prompts you for a COM port name such as "COM1" or "UDP" where your K7MDL Arduino RF power meter is attached
#   Usage:  pyRFPowerMeter COM6
#       Specify the port name on the command line and it will start up without user interaction
#   Usage:  pyRFPowerMeter COM6 HIDE
#       Specify the port name on the command line and hide the frame's title bar to save desktop space
#  *********************************************************************************************************

# This app is the companion application to the PSOC5LP and Arduino based RF power meter poject by K7MDL
#   It has no usage without one or more of the Arduino/PSoC5 meters.  This app listens to a serial port and 
#   displays the results in a small fixed size GUI window.  
#   It also sends commands to the meter such as to change calibration sets when you change frequency
#   You could emulate the same simple data format of 8 string fields and use this for your own device
#   The deafult serial rate (found at bottom of code below) is 115200 to match the default in my PSoC5/Arduino meter code

# This app accepts 2 command line arguments --  The serial port to use and the meter ID (100-119).
#   It will prompt for a USB Serial Port if one is not supplied on teh command line
#   In normal usage you would specify the com port to be used on the command line in a desktop shortcut or a batch file.  
#   You could also specify the "port_name" in the code at the bottom of this script

# Change these 2 lines to suit your station
myTitle = ("K7MDL Remote Power Meter " + PowerMeterVersionNum)      # Windows Title Bar Text

# edit these to match your meter ID and Rig/Location text for this meter instance
myRig = "Cabinet"       # Rig name and location - about 10 characters max
myRig_meter_ID = "100"                 #  Change to set your default meter ID.  Overridden on cmd line or config file
                           # --> Always 3 digits, 100 to 119 only allowed.  
#myWSJTX_ID = "WSJT-X-None"     # "WSJT-X" default as of WSJT-X version V2.1.   Change this to match your WSJT-X instance name. See below.
#myWSJTX_ID = "WSJT-X - K3-VHF"      #  Personalized example - Change this to match your WSJT-X instance name. 
myWSJTX_ID = "NONE"  # Ignore WSJTX comms
# Can name your WSJT-X instance on startup with command line -r <rigname> in a desktop shortcut

# examples to inspire ....
#myRig = "K3 WA"           # My home in WA state
#myRig_meter_ID = "102"    # Change to match your power meter ID.

#myRig = "HF"              # the HF rig
#myRig_meter_ID = "103"    # Change to match your power meter ID.

#myRig = "MicroWave"       # a microwave transverter maybe
#myRig_meter_ID = "104"    # Change to match your power meter ID.

#myRig = "Field"           # sample name suggesting meter is a standalone used for testing, not assigned to a antenna or radio 
#myRig_meter_ID = "105"    # Change to match your power meter ID.

# addressing information of target
HIDE_POWER_INFO = 2   # set to 0 to show (normal) or 1 to hide Ref and SWR info only, 2 to hide all (Fwd, Ref and SWR)
ROTOR_ENABLE = 1  # 1 is ENABLED, any other value or commented out is DISABLED
myRotator_meter_ID = "100"        #  Change to match the meterIS in your rotator.
IPADDR_OF_ROTOR = '192.168.2.189'  # for rotator controller
PORTNUM_OF_ROTOR_LISTEN = 7947     # for rotator controller
PORTNUM_OF_ROTOR_SENDTO = 7946     # for rotator controller
IPADDR_OF_METER = '192.168.2.188'   # for RF Wattmeter/Band Decoder
PORTNUM_OF_METER_LISTEN = 7942      # for RF Wattmeter/Band Decoder - listen for packets from the meter at this port number
PORTNUM_OF_METER_SENDTO = 7943      # for RF Wattmeter/Band Decoder - send packets to the meter at this port number
#MY_UDP_IP = '224.255.0.1'       # multicast address and port alternative
MY_UDP_IP = "127.0.0.1"        # default local machine address
WSJTX_UDP_PORT = 2238  #2237 normal            # change to match your WSJTX source of data port number. 2237 is a common WSJTX default port.  See below for more info...
# I am using 2334 with JTAlert re-broadcasting

#  This program can optionally use WSJT-X UDP reporting broadcasts to automatically track your radio's frequency and send a command
#       to the Arduino RF Power meter to load the approriate calibration set.  11 bands are provided today.  
#       The remaining bands are all the VHF+ bands up to 10GHz by default  
#       You can change the labels in the code for the button band names to be anything.  Can also change them in the Arduino side.
#       The name is just a label, in the Arduino side is it used as a more friendly way to say BandX and represent a correspnding set of 
#           coupling factor + any attenuators + any cal correction factor for the detectors at a given frequency for 
#           the forward and reflected ports of a particular dual direction coupler.  
#       If you change couplers be sure to set new calibratiuon factors in the Arduino side as they are frequency sensitive as well as
#           could have different coupling factors such as 20dB or 30dB on each port.  
#       Single port couplers can be used as the dBm fields will be zero when the Forward port Watts is reported as 0W.  
#           The values will drift around on the unused port at other time and the SWR value may fluctuate.  Can edit these fields to blank if desired
#       In a pinch you could adjsut the incoming data values here.
#  WSJT uses 2237 to talk to JTAlert.  JTAlert can rebroadcast and uses 2334 by default.  
#  These ports can be changed in each program
#  Cannot open both this app and JTAlert on 2237 - bind conflict so set this app's port to 2334 to match the JTAlert
#  ==> If not using JTAlert make sure this port number is the same as configured in WSJT-X "UDP Port Number" field in Setting->Reporting tab
#  WSJT uses 2333 default for logged contact broadcast  
#  Can also use multicast address with WSJT but not sure how other programs like JTAlert work with it

#  If running multiple instances of WSJT-X (including on the same address for multicast usage)
#      you neeed to use the WSJTX ID to map the instance messages to the correct power meter app ID field.
#      Change the ID in the Arduino side code and set myRig__meter_ID above to match.  Must use a unique com port for each meter
#  By default the code here has wsjtx_id set to None and will read any and all WSJT-X instance status messages received.  
#      This will have the effect of constantly switching bands if the instances are reporting different frequency bands
#      You can asign a bogus UDP port nnumber to shut off WSJT-X message reception or tailor the WSJT-ID value described next.
#  
#  Each instance of WSJT-X has an instance name set with -rigname.  This name wil be used as the WSJTX_ID in all network messages
#  By default the this program is not filtering on this ID so wil lread any instance, including multiple instances which can get confusing
#  Change the WSJT-X ID in this code from None to teh name that matches your rigname.  
#  You can see the actual WSJTX ID received as it is dislayed in the terminal window each time a heartbeat is received
#      This is a section of the relevent code used in this script
#           if wsjtx_id is None and (type(the_packet) == pywsjtx.HeartBeatPacket):
#               # We have an instance of WSJTX
#               print("WSJT-X is detected, id is {}".format(the_packet.wsjtx_id))
#               print("--> HeartBeatPacket Received")
#               wsjtx_id = the_packet.wsjtx_id

# Global Vars
global s            # used to get network packet data
own_call = ""       # used for meter ID in Radio field of GUI when only network is on.
last_freq = ""      # used for detecting band changes from network
# This boolean variable will save the communications (comms) status
comms  = None   #  False is off.  App.comm wil then toggle to on state.
ser = None
port_name = None
restart_serial = 0
heartbeat_timer = 0
send_meter_cmd_flag = False   # Boolean to gate Serial thread to send cmd byte to meter.  Cmd comes from USB thread
out = ""
s_data = ""
cmd = ""
cmd_data = ""
meter_data = ["","","","","","","","","",""]
meter_data_fl  = [0.0,0.0,0.0,0.0,0.0,0.0,0.0,0.0,0.0,0.0] # stores the same info in same psotion when possible as a float
meter_data2 = ["","","","","","","","","",""]
meter_data_fl2  = [0.0,0.0,0.0,0.0,0.0,0.0,0.0,0.0,0.0,0.0] # stores the same info in same psotion when possible as a float
cal_flag = 0
cmd_flag = 0
FwdVal_Hi = ""
FwdVal_Lo = ""
RefVal_Hi = ""
RefVal_Lo = ""
hide_titlebar = FALSE
Dis_OTRPS_Ch_flag = 0
Inp_Val = 0
PortA_Val = 0
PortB_Val = 0
PortC_Val = 0
InputPort_pattern = 0
PortA_pattern = 0
PortB_pattern = 0
PortC_pattern = 0
PTT_IN_POLARITY_Val = 0
PTT_OUT_POLARITY_Val = 0
CW_KEY_OUT_POLARITY_val = 0
PORTA_IS_PTT_Val = 0
PORTB_IS_PTT_Val = 0
PORTC_IS_PTT_Val = 0
my_git_site = "https://github.com/K7MDL2/RF-Power-Meter-V1"
pywsjtx_git_site = "https://github.com/bmo/py-wsjtx"
nextion_git_site = "https://github.com/itead/ITEADLIB_Arduino_Nextion"
update_cfg_win_callback = None
meter_sock = None
rotor_action = ["",""]
rotor_sock = None
rotor_data = ["","","","","","","","","","",""]
send_rotor_cmd_flag = False
rotor_cmd = ""
rotor_cmd_data = ""
TX_Status = "0"  # 0 is RX, 1 is TX state, updated by message 173 from meer for realtime state


def isfloat(x):
    # Check if the received 4 characters can be converted to a float
    try:
        float(x)
        return True
    except ValueError:
        return False
#
#__________  UDP Rotator Network handler in its own thread.  ________________________________________________________________
#               Monitors and Commands Rotator controller
#   
class UDP_Rotor(Thread):
    def __init__(self):
        #self.setDaemon(True)
        # Call Thread constructor
        super().__init__()
        if ROTOR_ENABLE == 0:
            print("Rotator Feature not enabled")
            return
        self.keep_running_UDP_Rotor = True
        print(" UDP Rotor Network Thread Startup ^^^^^^^^^^")

    def stop(self):
        # Call this from another thread to stop the serial handling process
        self.keep_running_UDP_Rotor = False
        t = socket.socket(socket.AF_INET, socket.SOCK_DGRAM)
        t.close()
        print(" UDP Rotor Control Network Thread Stopping ^^^^^^^^^^")

    def run(self):
        # This will run when you call .start method
        while self.keep_running_UDP_Rotor:
            self.UDP_Rotor_Rx()
            self.UDP_Rotor_Tx()
            time.sleep(0.05)

    def UDP_Rotor_Tx(self):
        global rotor_cmd
        global rotor_cmd_data   # UI buttons for rotator commands will set flag true and populate rotor_cmd and rotor_cmd_data
        global send_rotor_cmd_flag
        global myRotator_meter_ID
       
        if (send_rotor_cmd_flag == True and ROTOR_ENABLE == 1):  
            print("Send UDP Rotor Commands")
            send_rotor_cmd_flag = False  
            # Send out to ethernet via UDP also if enabled
            # initialize a socket, think of it as a cable
            # SOCK_DGRAM specifies that this is UDP
            t = socket.socket(socket.AF_INET, socket.SOCK_DGRAM)
            try:
                # send the command
                m = "{},120,{},{},{}" .format(myRotator_meter_ID,rotor_cmd,rotor_cmd_data,'\n').encode()
                t.sendto(m, (IPADDR_OF_ROTOR, PORTNUM_OF_ROTOR_SENDTO))
                print("TX to Rotator Controller Msg = {}" .format(m)) 
            except Exception as e:
                print("TX to Rotator Controller FAILED Error = {}" .format(e)) 
                #pass
            # close the socket
            t.close() 
        #time.sleep(0.1) 
           
    def UDP_Rotor_Rx(self):
        global rotor_sock
        global rotor_data
        global rotor_action
        buf = {}
        r_data = None
        
        if (ROTOR_ENABLE == 1):          
            #print(" Listening for UDP Rotator Controller messages")        
            try:                
                buf, sender = rotor_sock.recvfrom(1024)
                #if sender > 1000: print(sender)    # just gets rid of unused var error, does nothing for us here.
                #print("Received message before decode: {}" .format(buf))
                r_data = buf.decode()
                
                #try:
                #    r_data = buf.decode("utf-8")  #encoding='ascii', errors='ignore')
                #except:
                #    r_data = buf.decode("ascii", errors='ignore')
                #if s_data[0][0] == "R":
                #    print("ROTOR CMD received message echo: {}" .format(r_data))
                #else:
                #print("received message: {}" .format(r_data))
                #pd.get_power_data(pd, str(r_data))   # usew this for now, latewr separate out.
                if r_data != '':
                    tempstr =  str(r_data).split('\r')
                    #print("ROTOR DATA = {}" .format(tempstr))
                    # break out rotator controller messages
                    if tempstr[0][0] == 'R' and tempstr[0][1] == 'T' and tempstr[0][2] == 'R' and tempstr[0][3] == '1':                                                            
                        if (tempstr[0][4] != ':'):                        
                            rotor_action[0] = str(tempstr[0])    # store this to append to next AZ print for compactness                                            
                            return
                        else:
                            if rotor_action == {}:
                                rotor_action[0] = ""  # initialize var first time used or it wont print below until a command is given.
                        #print("Rotor Status {}" .format(tempstr[0]))
                        rotor_data = str(tempstr[0]).split(" ")
                        #print("{} {}" .format(rotor_data[10], rotor_action[0]))   # print out Az and last action, if any.  These messages will alternate so combine them here.
                        rotor_action[0] = ""
                        return
            except UnicodeDecodeError: # catch error and ignore it
                print("Unicode decode error caught")  # will get this on CPU resets
            except socket.timeout:
                pass
                #print("Timeout on data received from UDP")
            except socket.error:
                #print("No data received from UDP")    
                pass
        #time.sleep(0.1)
# 
#_________  UDP Message Handler in its own thread______________________________________________________________________________
#   Separate threads for WSJTX and UDP comms to the meter and the serial comms.  
#  
class UDP_Meter(Thread):
    def __init__(self):
        #self.setDaemon(True)
        # Call Thread constructor
        super().__init__()
        self.keep_running_UDP = True
        print(" UDP Network Thread Startup ^^^^^^^^^^")
        if comms != None:
            print("Should not be here in UDP_Meter thread right now")
            return

    def stop(self):
        # Call this from another thread to stop the serial handling process
        self.keep_running_UDP = False
        t = socket.socket(socket.AF_INET, socket.SOCK_DGRAM)
        t.close()
        print(" UDP Network Thread Stopping ^^^^^^^^^^")

    def run(self):
        # This will run when you call .start method
        while self.keep_running_UDP:
            self.UDP_Rx()
            self.UDP_Tx()
            time.sleep(0.05)
    
    def UDP_Tx(self):
        global send_meter_cmd_flag
        global comms
        global cmd_data
        global cmd
        global myRig_meter_ID
       
        if (comms == None and send_meter_cmd_flag == True):  
            print("send commands")
            send_meter_cmd_flag = False  
            # Send out to ethernet via UDP also if enabled
            # initialize a socket, think of it as a cable
            # SOCK_DGRAM specifies that this is UDP
            t = socket.socket(socket.AF_INET, socket.SOCK_DGRAM)
            try:
                # send the command
                m = "{},120,{},{},{}" .format(myRig_meter_ID,cmd,cmd_data,'\n').encode()
                t.sendto(m, (IPADDR_OF_METER, PORTNUM_OF_METER_SENDTO))
                print("TX to CPU Msg = {}" .format(m)) 
            except Exception as e:
                print("TX to CPU FAILED Error = {}" .format(e)) 
                #pass
            # close the socket
            t.close() 
        #time.sleep(0.1) 
           
    def UDP_Rx(self):
        global s_data
        global comms
        global meter_sock
        pd = Power_Data
        buf = {}
        
        if (comms == None):          
            #print(" listening for UDP messages")
            try:                
                buf, sender = meter_sock.recvfrom(4096)
                #if sender > 1000: print(sender)    # just gets rid of unused var error, does nothing for us here.
                #print("Received message before decode: {}" .format(buf))
                #s_data = buf.decode()
                #print(s_data)
                #try:
                s_data = buf.decode(encoding="utf-8", errors='ignore')
                #except:
                #    s_data = buf.decode("ascii", errors='ignore')
                if s_data[0] == ">":
                    print("CMD received message echo: {}" .format(s_data))
                #else:
                #print("Rcvd: {}" .format(s_data))
                pd.get_power_data(pd, str(s_data))
            except UnicodeDecodeError: # catch error and ignore it
                print("Unicode decode error caught")  # will get this on CPU resets
            except socket.timeout:
                pass
                #print("Timeout on data received from UDP")
            except socket.error:
                #print("No data received from UDP")    
                pass  
        #time.sleep(0.1)
#
#__________  Network handler in its own thread.  ________________________________________________________________
#               Monitors WSJT-X broadcast packets to extract frequency for band changing
#   
class WSJTX_Decode(Thread):   # WSJTX and UDP rx thread
    def __init__(self):
        # Call Thread constructor
        super().__init__()
        #self.setDaemon(True)
        self.daemon = True
        self.keep_running_WSJTX = True
        #print("WSJTX Start")
        global s
        s = simple_server.SimpleServer(MY_UDP_IP, WSJTX_UDP_PORT, timeout=2.0)
        #s = pywsjtx.extra.simple_server.SimpleServer(UDP_IP, UDP_PORT, timeout=2.0)
        print(" Starting WSJT-X Network Thread")

    def stop(self):
        # Call this from another thread to stop the WSJTX_Decode
        self.keep_running_WSJTX = False
        print(" Stopping WSJTX network thread^^^^^^^^^^")
        #print(thread_names)

    #def run(self):
        # This will run when you call .start method
        while self.keep_running_WSJTX:          
            self.wsjt_reader()   # Check for WSJT-X packets

    def wsjt_reader(self):
        # We use select here so that we are not *hung* forever in recvfrom.
        # We'll wake up every .5 seconds to check whether we should keep running
        #rfds, _wfds, _xfds = select.select([self.sock], [], [], 0.5)
        #if self.sock in rfds:    
        wsjtx_id = None    
        global last_freq
        global meter_data
        global own_call
        global heartbeat_timer
        global band
        
        #print("Listening for WSJTX messages")
        #time.sleep(0.5)
        (pkt, addr_port) = s.rx_packet()
        if (pkt != None):
            the_packet = pywsjtx.WSJTXPacketClassFactory.from_udp_packet(addr_port, pkt)
            print("Looking only for WSJT-X ID of : {}" .format(myWSJTX_ID))
            if wsjtx_id is None and (type(the_packet) == pywsjtx.HeartBeatPacket):                
                # we have an instance of WSJTX
                print("WSJT-X is detected, id is {}".format(the_packet.wsjtx_id))
                print("--> HeartBeatPacket Received")
                wsjtx_id = the_packet.wsjtx_id
                heartbeat_timer = 0  # reset upcounter
            if type(the_packet) == pywsjtx.StatusPacket:
                wsjtx_id = the_packet.wsjtx_id
                own_call = the_packet.de_call
                if wsjtx_id == myWSJTX_ID:   # match on a selected instance of WSJT-X only
                    print("Status message received from WSJT-X ID {} for call {}: " .format(wsjtx_id, own_call))
                    freq = str(the_packet.dial_frequency)
                    freq = str(freq[:-6])                    
                    if  freq != "":                     
                            band = meter_data[2]
                            band = str(band[:-3])
                            if band != freq or freq != last_freq:
                                #print(" Meter band not matched to radio: Meter: {}  Radio: {}" .format(band, freq))                    
                                Send_Mtr_Cmds.send_meter_cmd(self, int(freq), "", False)
                                print('{} {} {} {} {} {}' .format("Dial Frequency is : ", freq, "    Was : ", last_freq, "   Meter Band : ", band))                            
                                last_freq = freq                                
                            else:
                                print("Frequency Now " + freq)       
        #time.sleep(0.1)
#
#_________  Serial Port Handler in its own thread______________________________________________________________________________
#  Handles the Serial Port Rx and TX duties
#
class Serial_RxTx(Thread):
    def __init__(self):
        # Call Thread constructor
        super().__init__()
        self.open_serial_port()        
        self.keep_running = True
        print(" ^^^^^^^^^^^^^serial thread startup ^^^^^^^^^^")

    def stop(self):
        # Call this from another thread to stop the serial handling process
        self.keep_running = False
        self.close_serial_port()

    def run(self):
        # This will run when you call .start method
        while self.keep_running:
            self.meter_reader()
            self.ser_meter_cmd()

    def open_serial_port(self):
        print(" Attempting to open Serial port in Thread^^^^^^^^^^")
        if ser.isOpen() == False:        
            try:
                ser.open()
                ser.flushInput()
            except serial.SerialException:
                print ("error communicating...: " + str(port_name))
        else:
            print("Cannot open serial port "  + str(port_name))

    def close_serial_port(self):
        if ser.isOpen():        
            try:
                ser.close()                
            except serial.SerialException:
                print ("error communicating while closing serial port: " + str(port_name))
        else:
            print("Serial port already closed:  "  + str(port_name))

    def ser_meter_cmd(self):
        global send_meter_cmd_flag
        global cmd
        global cmd_data        
        if send_meter_cmd_flag == True and comms != None:   # if True then the UDP thread has a cmd waiting to send out.       
            if ser.isOpen():
                try:              
                    print("---> Write Cmd:{}  Cmd2:{}" .format(str(cmd), str(cmd_data)))                    
                    ser.write("{},120,{},{},{}" .format(myRig_meter_ID,cmd,cmd_data,'\n').encode())
                    print("---> Write Completed")
                    send_meter_cmd_flag = False                             
                except serial.SerialException:
                    print ("error communicating while writing serial port: " + str(port_name))
            else:
                print("cannot access serial port to send commands")    
        #time.sleep(0.1) 
        
    def meter_reader(self):       
        global restart_serial
        
        out = ""  # Preparing the out variable 
        try:
            if restart_serial == 0:                             
                if ser.isOpen():                                
                    try:                           
                        waiting = ser.inWaiting()
                        if waiting == 0:
                            time.sleep(0.05)
                            return
                        out = ser.read(waiting).decode()
                        if len(out) < 1:
                            time.sleep(0.05)
                            return    
                        #print(out)
                        Power_Data.get_power_data(self, out)                                           
                    except UnicodeDecodeError: # catch error and ignore it
                        print("Unicode decode error caught")  # will get this on CPU resets
                    except serial.SerialException:
                        # There is nothing
                        print("No Data waiting at serial port: " + str(port_name))
                        restart_serial = 1      # restart serial_Rx thread to recover
                        return None
                    except TypeError as e:
                        restart_serial = 1      # restart serial_Rx thread to recover
                        print("Error communicating while reading serial port: " + str(port_name))
                        print(e)
                    else:
                        #print(out)
                        pass
                else:
                    time.sleep(0.05)
                    pass
            else:
                print("Cannot access serial port to read input data")
                restart_serial = 1      # restart serial_Rx thread to recover
        except serial.SerialException as e:
            print(" Error: Port access issue detected. Possibly disconnected USB cable.")
            print(" --> Shutting off comms. Hit \'On\' button to resume once problem is resolved. Actual error below:")                
            print(e)
            restart_serial = 1
        #time.sleep(0.1)

#
# __________  Process power meter received data ________________________________________________________________
#  Extracts data from either the Newtwork or Serial threads incoming messages 
#  
class Power_Data():
    #def __init__(self):
        #self.get_power_data(self, self.s_data)

    def get_power_data(self, s_data):
        global meter_data
        global meter_data_fl
        global meter_data2
        global meter_data_fl2
        global cal_flag
        global cmd_flag
        global FwdVal_Hi
        global FwdVal_Lo
        global RefVal_Hi
        global RefVal_Lo
        global Dis_OTRPS_Ch_flag
        global Inp_Val
        global PortA_Val
        global PortB_Val
        global PortC_Val
        global InputPort_pattern
        global PortA_pattern
        global PortB_pattern
        global PortC_pattern
        global PTT_IN_POLARITY_Val
        global PTT_OUT_POLARITY_Val
        global CW_KEY_OUT_POLARITY_val
        global PORTA_IS_PTT_Val
        global PORTB_IS_PTT_Val
        global PORTC_IS_PTT_Val
        global TX_Status
        global TX_Status_Last

        try:            
            if s_data != '':
                #print("1  RAW DATA {}" .format(s_data))
                tempstr =  str(s_data).split('\r')
                #print("1  DATA HERE {}" .format(tempstr))
                if tempstr[0][0] == '>':   # Break out debug messages and skip processing
                    print("0 Dbg Msg = {}" .format(tempstr))    
                    return
                meter_data_tmp = tempstr[0].split(",")  # break comma separated values into a list
                #print("2 TMP raw str   = {}" .format(meter_data_tmp))
                if len(meter_data_tmp) >= 3:
                    meter_data[0] = meter_data_tmp[0]  
                    if meter_data_tmp[0] == myRig_meter_ID: 
                        if meter_data_tmp[1] == "150":   # Cal Table Dump Messages
                            #print("Cal Dump")
                            print("{}" .format(meter_data_tmp))
                        elif meter_data_tmp[1] == "161":   # Cal progress message start
                            cal_flag = 1
                            FwdVal_Hi = meter_data_tmp[3]
                            FwdVal_Lo = meter_data_tmp[4]
                            RefVal_Hi = meter_data_tmp[5]
                            RefVal_Lo = meter_data_tmp[6]  
                            print("Voltages = ", meter_data_tmp)
                        elif meter_data_tmp[1] == "160":   # Cal progress message end
                            cal_flag = 0
                        elif meter_data_tmp[1] == "163":   # Cmd progress message start
                            cmd_flag = 1       
                            print(" -------------cmd flag = 1 -------------")                            
                        elif meter_data_tmp[1] == "162":   # Cmd progress message end
                            cmd_flag = 0                            
                            print(" -------------cmd flag = 0 -------------")
                        elif meter_data_tmp[1] == "173":   # real time PTT status
                            if TX_Status != meter_data_tmp[3]:
                                TX_Status = meter_data_tmp[3]       # only process changes
                                if TX_Status == "1":
                                    print(" -------------Changed to TX State  {}" .format(TX_Status))
                                else:
                                    print(" -------------Changed to RX State  {}" .format(TX_Status))                            
                        elif meter_data_tmp[1] == "172":   # Get Band Decoder Translation Mode Values resulting from Message to CPU #60
                            Dis_OTRPS_Ch_flag = meter_data_tmp[2]   # Get OTRSP band change enable state
                            Inp_Val = meter_data_tmp[3]             # Band Decoder Input Port Translation Value
                            PortA_Val = meter_data_tmp[4]           # Band Decoder Port A Translation Value
                            PortB_Val = meter_data_tmp[5]           # Band Decoder Port B Translation Value
                            PortC_Val = meter_data_tmp[6]           # Band Decoder Port C Translation Value
                            InputPort_pattern = meter_data_tmp[7]   # Band Decoder Input Port Custom Pattern Value
                            PortA_pattern = meter_data_tmp[8]       # Band Decoder Port A Custom Pattern Value
                            PortB_pattern = meter_data_tmp[9]      # Band Decoder Port B Custom Pattern Value
                            PortC_pattern = meter_data_tmp[10]      # Band Decoder Port C Custom Pattern Value
                            PTT_IN_POLARITY_Val = meter_data_tmp[11]     # Band Decoder PTT input Active HI/LO
                            PTT_OUT_POLARITY_Val = meter_data_tmp[12]    # Band Decoder PTT output Active HI/LO
                            CW_KEY_OUT_POLARITY_val = meter_data_tmp[13]    # Band Decoder CW_KET from OTRSP Active HI/LO
                            PORTA_IS_PTT_Val = meter_data_tmp[14]    # Band Decoder PortA follow PTT Active HI/LO
                            PORTB_IS_PTT_Val = meter_data_tmp[15]    # Band Decoder PortB follow PTT Active HI/LO
                            PORTC_IS_PTT_Val = meter_data_tmp[16]    # Band Decoder PortC follow PTT Active HI/LO
                            print("Band Decoder Translation Mode Values from CPU = ", meter_data_tmp)
                        elif meter_data_tmp[1] == "171":   # voltage, current and temperature data
                            meter_data2 = meter_data_tmp  
                            #print(" HV, 14V, Curr and Temp Data = {}" .format(meter_data_tmp))      
                            for i in range(len(meter_data2)):                    
                                if isfloat(meter_data2[i]):                                                                    
                                    meter_data_fl2[i] = float(meter_data2[i])
                                else: # Not a float so zero fill the field
                                    meter_data_fl2[i] = 0.0             
                        elif meter_data_tmp[1] == "170":   # normal power data
                            meter_data = meter_data_tmp        
                            for i in range(len(meter_data)):                    
                                if isfloat(meter_data[i]):                                                                    
                                    meter_data_fl[i] = float(meter_data[i])
                                else: # Not a float so zero fill the field
                                    meter_data_fl[i] = 0.0
                            meter_data_fl[2] = float(meter_data[2][:-3])    # convert band label to a number.  Ideally would use a RegEx to split at the end of the numbers
                            if meter_data_fl[5] == 0 and cmd_flag != 1:
                                meter_data[3] = "0.0"          #  zero out the dBm values when F watts is zero
                                meter_data[4] = "0.0"
                            #print("{0:}    = {1:}" .format("3 ID Match Data ", meter_data))
                            #print("{0:} FLT= {1:}" .format("3 ID Match Data ", meter_data_fl))
                        else:                            
                            print(" Msg from meter = {}" .format(meter_data_tmp))
                            for i in len(meter_data):
                                meter_data[i] = ""
                                meter_data_fl[i] = 0.0
                    else:  # No ID Match
                        #print("Non Matching Meter ID = ", meter_data[0])
                        #self.debug_meter_string("4 No ID Match   ")
                        #meter_data[0] = "NA"          # no meter ID match so tell the UI  
                        pass
                else:   # Not 8 Elements
                    s_data = ""
                    #self.debug_meter_string("5 Not 8 Elements")                    
                    #meter_data[0] = "NA"          # no meter ID match so tell the UI  
            else:
                #self.debug_meter_string("6 Empty String  ")
                meter_data[0] = "NA"          # no meter ID match so tell the UI  
        except:
                pass
        #time.sleep(0.001)

    def debug_meter_string(self, debug_msg):
        for i in range(len(meter_data)):
            meter_data[i] = ""
            meter_data_fl[i] = 0.0
        print("{0:}    = {1:}" .format(debug_msg, meter_data))
        print("{0:} FLT= {1:}" .format(debug_msg, meter_data_fl))
        
#
#_____________________________________________________________________________________________________________
# Used by the app to queue up a command to be sent the meter via either of the Network and Serial threads.
#
class Send_Mtr_Cmds():
    def send_meter_cmd(self, cmd_str, cmd_data_str, direct_cmd):
        # cmd is type chr to be converted to byte
        # direct_cmd is BOOL to specify if it is a direct command such as button push for 144 
        #    vs a UDP freqwuency which can vary in a range
        # direct_cmd is True to do a direct command
        # since serial and network and GUI are seperate threads, using a semaphore to specify that
        #   a command is waitng to go out.  The serial thread will pick it up when there is time between receives

        global send_meter_cmd_flag
        global cmd
        global cmd_data
 
        # parse the frequency passed to call specific band command byte to be sent by another function
        #print("Meter Cmd Order is to " + str(cmd))
        send_meter_cmd_flag = True
        if direct_cmd == True:              
            cmd = cmd_str           # now handle direct bands change commands
            cmd_data = cmd_data_str     # set data value if any. 
            #print(" ******> Direct cmd byte = " + str(cmd))
            print("meter cmd={} cmd2={}" .format(cmd, cmd_data))
        else:            
            cmd_data = 0        # data value always zero for band change commands
            band = int(cmd_str)           # non direct band change commands, usually from sources like WSJT-X where a frequency is provided rather than specific band info.
            if band < 4:
                cmd = "230"
            elif 3 < band < 5:
                cmd = "231"
            elif 4 < band < 6:
                cmd = "232"
            elif 5 < band < 8:
                cmd = "233"
            elif 7 < band < 11:
                cmd = "234"
            elif 10 < band < 15:
                cmd = "235"
            elif 14 < band < 19: 
                cmd = "236"
            elif 18 < band < 22: 
                cmd = "237"
            elif 21 < band < 25: 
                cmd = "238"
            elif 24 < band < 28: 
                cmd = "239"
            elif 27 < band < 50: 
                cmd = "240"
            elif 49 < band < 70:
                cmd = "241"
            elif 69 < band < 200:
                cmd = "242"
            elif 199 < band < 300:
                cmd = "243"
            elif 299 < band < 600:
                cmd = "244"
            elif 599 < band < 1000:
                cmd = "245"
            elif 999 < band < 2000: 
                cmd = "246"
            elif 1999 < band < 3000: 
                cmd = "247"
            elif 2999 < band < 4000: 
                cmd = "248"
            elif 3999 < band < 8000: 
                cmd = "249"
            elif band > 7999: 
                cmd = "250"
            else: 
                pass                    # in case we add more
        #time.sleep(0.0001)

# # # _____________________Window Frame Handler for the GUI and managing starting and stopping._____________________________
# # #                       
class App(tk.Frame):
    STRIDE = 8
    DELAY = 100

    def __init__(self, master=None):
        # Call superclass constructor
        super().__init__(master)
        self.serial_rx = None
        #self.WSJTX_Decode = WSJTX_Decode()
        #self.WSJTX_Decode = None
        self.udp_meter = None
        self.udp_rotor = None
        #self.grid()
        self.pack_propagate(0) # don't shrink
        self.pack(fill=BOTH, expand=1)
        self.createWidgets()
        self.update()
        self.master.protocol("WM_DELETE_WINDOW", self.exit_protocol)
        print(threading.enumerate())

    def exit_protocol(self):
        # Will be called when the main window is closed
        # It should close the serial port if it has not
        # been previously closed
        #global comms

        #if comms:
        #if ser.isOpen() == True:                
        if self.serial_rx:
            self.serial_rx.stop()
        #if self.wsjtx_decode:
        #    self.wsjtx_decode.stop() 
        if self.udp_meter:
            self.udp_meter.stop() 
        if self.udp_rotor:
            self.udp_rotor.stop() 
                    
        self.master.destroy()  # Destroy root window
        self.master.quit()  # Exiting the main loop
        #print(thread_names)
        #sys.exit(" sys exit called")

    #---- Create the GUI Layout ----
    def createWidgets(self):
        global meter_data
        global meter_data_fl
        global meter_data2
        global meter_data_fl2
        global restart_serial
        global own_call

        self.btn_font = tkFont.Font(family="Helvetica", size=10, weight='bold')

        self.QUIT = tk.Button(self,
                                    text = format("ON"),
                                    font = self.btn_font,
                                    relief = tk.RIDGE,
                                    fg = "black",
                                    padx = 4,
                                    #state='disabled',
                                    command = self.comm)     # Will call the comms procedure to toggle all comms 
        self.QUIT.place(x=10, y=0, bordermode=OUTSIDE, height=20, width=40) 
        if restart_serial:
            self.QUIT.configure(fg='black', bg="light grey") 
        else:
            self.QUIT.configure(fg='white', bg="red") 
        if comms == None:
            self.QUIT.configure(text = format("OFF"), fg='grey', bg="light grey")

        self.band_f = tk.Button(self)
        self.band_f["text"] = "Reset-"
        self.band_f["command"] = self.change_band  # Change the band (cycle through them)
        self.band_f.configure(font=self.btn_font)
        self.band_f.place(x=50, y=0, bordermode=OUTSIDE, height=20, width=40) 

        self.scale = tk.Button(self)
        self.scale["text"] = "Cal?"
        self.scale["command"] = self.get_cal_table  # Change to Watts and change scale
        self.scale.configure(font=self.btn_font)
        self.scale.place(x=90, y=0, bordermode=OUTSIDE, height=20, width=40) 

#       These bands can be enabled but will need to place them and slide around the voltage, curr and temp

#        self.band_23G = tk.Button(self)
#        self.band_23G["text"] = "2.3G"
#        self.band_23G["command"] = self.band_2300  # Jump to Band X
#        self.band_23G.configure(fg='grey',font=self.btn_font, padx=1, state='normal')
#        self.scale.place(x=XX, y=0, bordermode=OUTSIDE, height=20, width=40)

#        self.band_34G = tk.Button(self)
#        self.band_34G["text"] = "3.4G"
#        self.band_34G["command"] = self.band_3400  # Jump to Band X
#        self.band_34G.configure(fg='grey',font=self.btn_font, padx=1, state='normal')
#        self.scale.place(x=XX, y=0, bordermode=OUTSIDE, height=20, width=40)

#        self.band_57G = tk.Button(self)
#        self.band_57G["text"] = "5.7G"
#        self.band_57G["command"] = self.band_5700  # Jump to Band X
#        self.band_57G.configure(fg='grey',font=self.btn_font, padx=1, state='normal')
#        self.scale.place(x=XX, y=0, bordermode=OUTSIDE, height=20, width=40)

#        self.band_10G = tk.Button(self)
#        self.band_10G["text"] = "10G"
#        self.band_10G["command"] = self.band_10g  # Jump to Band X
#        self.band_10G.configure(fg='grey',font=self.btn_font, padx=3, state='normal')
#        self.scale.place(x=XX, y=0, bordermode=OUTSIDE, height=20, width=40)

        self.band_HFM = tk.Button(self)
        self.band_HFM["text"] = " HF "
        self.band_HFM["command"] = self.band_HF  # Jump to Band X
        self.band_HFM.configure(fg='black',font=self.btn_font, padx=2, state='normal')
        self.band_HFM.place(x=135, y=0, bordermode=OUTSIDE, height=20, width=36)

        self.band_50M = tk.Button(self)
        self.band_50M["text"] = " 50 "
        self.band_50M["command"] = self.band_50  # Jump to Band X
        self.band_50M.configure(fg='black',font=self.btn_font, padx=2, state='normal')
        self.band_50M.place(x=171, y=0, bordermode=OUTSIDE, height=20, width=36)

        self.band_144M = tk.Button(self)
        self.band_144M["text"] = "144"
        self.band_144M["command"] = self.band_144  # Jump to Band X
        self.band_144M.configure(fg='black',font=self.btn_font, padx=5, state='normal')
        self.band_144M.place(x=208, y=0, bordermode=OUTSIDE, height=20, width=36)

        self.band_222M = tk.Button(self)
        self.band_222M["text"] = "222"
        self.band_222M["command"] = self.band_222  # Jump to Band X
        self.band_222M.configure(fg='black',font=self.btn_font, padx=5, state='normal')
        self.band_222M.place(x=245, y=0, bordermode=OUTSIDE, height=20, width=36) 

        self.band_432M = tk.Button(self)
        self.band_432M["text"] = "432"
        self.band_432M["command"] = self.band_432  # Jump to Band X
        self.band_432M.configure(fg='black',font=self.btn_font, padx=5, state='normal')
        self.band_432M.place(x=282, y=0, bordermode=OUTSIDE, height=20, width=36) 

        self.band_902M = tk.Button(self)
        self.band_902M["text"] = "902"
        self.band_902M["command"] = self.band_902  # Jump to Band X
        self.band_902M.configure(fg='black',font=self.btn_font, padx=5, state='normal')
        self.band_902M.place(x=319, y=0, bordermode=OUTSIDE, height=20, width=36) 

        self.band_1296M = tk.Button(self)
        self.band_1296M["text"] = "1296"
        self.band_1296M["command"] = self.band_1296  # Jump to Band X
        self.band_1296M.configure(fg='black',font=self.btn_font, padx=1, state='normal')
        self.band_1296M.place(x=356, y=0, bordermode=OUTSIDE, height=20, width=36) 

        #  Voltage, Current and Temp
        self.hv = tk.Label(self, text=' HV:',font=('Helvetica', 10, 'bold'))
        self.hv.configure(font=self.btn_font)
        self.hv.place(x=404, y=0, bordermode=OUTSIDE, height=20, width=30)

        self.hv_a = tk.Label(self, text=' ', font=('Helvetica', 10, 'bold'))
        self.hv_a.configure(fg='yellow', bg="black", pady = 0)  
        self.hv_a.place(x=434, y=0, bordermode=OUTSIDE, height=20, width=34)

        self.v14 = tk.Label(self, text='12V:',font=('Helvetica', 10, 'bold'))
        self.v14.configure(font=self.btn_font)
        self.v14.place(x=476, y=0, bordermode=OUTSIDE, height=20, width=30)

        self.v14_a = tk.Label(self, text=' ', font=('Helvetica', 10, 'bold'))
        self.v14_a.configure(fg='yellow', bg="black", pady = 0)          
        self.v14_a.place(x=506, y=0, bordermode=OUTSIDE, height=20, width=34)
 
        self.curr = tk.Label(self, text='Amps:',font=('Helvetica', 10, 'bold'))
        self.curr.configure(font=self.btn_font)
        self.curr.place(x=549, y=0, bordermode=OUTSIDE, height=20, width=40)
       
        self.curr_a = tk.Label(self, text=' ', font=('Helvetica', 10, 'bold'))
        self.curr_a.configure(fg='yellow', bg="black", pady = 0)          
        self.curr_a.place(x=592, y=0, bordermode=OUTSIDE, height=20, width=34)
        
        self.temperature = tk.Label(self, text='T:',font=('Helvetica', 10, 'bold'))
        self.temperature.configure(font=self.btn_font)
        self.temperature.place(x=634, y=0, bordermode=OUTSIDE, height=20, width=17)

        self.temperature_a = tk.Label(self, text=' ', font=('Helvetica', 10, 'bold'))
        self.temperature_a.configure(fg='yellow', bg="black", pady = 0)          
        self.temperature_a.place(x=651, y=0, bordermode=OUTSIDE, height=20, width=48)
        
        #This label is just a buffer to prevent the SWR value from touching the right edge of a resized window
        self.spacer3 = tk.Label(self, text=' ', font=('Helvetica', 10, 'bold'))
        self.spacer3.place(x=706, y=0, bordermode=OUTSIDE, height=20, width=10)
        
        # Fill in text label to help identify multiple meters.  Text not needed for 1 meter usage
        self.spacer4 = tk.Label(self, text='  ', font=('Helvetica', 10, 'bold'))
        self.spacer4.place(x=0, y=22, bordermode=OUTSIDE, height=20, width=10)
               
        self.meter_id_l = tk.Label(self, text='Radio: ',font=('Helvetica', 10, 'bold'),pady=0,anchor="w", relief=tk.FLAT, borderwidth=1)  #, width=21)
        self.meter_id_l.configure(font=self.btn_font)
        self.meter_id_l.place(x=10, y=22, bordermode=OUTSIDE, height=20, width=50) 

        self.meter_id_f = tk.Label(self, text='           ',font=('Helvetica', 10, 'bold'),pady=0,anchor="w", relief=tk.FLAT, borderwidth=1)  #, width=21)
        self.meter_id_f.configure(font=self.btn_font)
        self.meter_id_f.place(x=54, y=22, bordermode=OUTSIDE, height=20, width=100) 
 
        self.band_l = tk.Label(self, text='Band: ',font=('Helvetica', 10, 'bold'),padx = 5,pady = 0, anchor="w", width=7)
        self.band_l.configure(font=self.btn_font)
        self.band_l.place(x=140, y=22, bordermode=OUTSIDE, height=20, width=46)  
        
        self.band_f = tk.Label(self, text='%7s' % "       ",font=('Helvetica', 10, 'bold'),padx = 5,pady = 0, anchor="w", width=7)
        self.band_f.configure(font=self.btn_font)
        self.band_f.place(x=186, y=22, bordermode=OUTSIDE, height=20, width=66)
         
        self.F_Watts_f = tk.Label(self, text=' FWD:', font=('Helvetica', 12, 'bold'),anchor="e",width=5)
        self.F_Watts_f.configure(font=self.btn_font, pady = 0)          
        self.F_Watts_f.place(x=250, y=22, bordermode=OUTSIDE, height=20, width=44) 

        self.F_Watts_a = tk.Label(self, text=' ', font=('Helvetica', 12, 'bold'),anchor="e", width=7)
        self.F_Watts_a.configure(fg='yellow', bg="black", pady = 0)          
        self.F_Watts_a.place(x=294, y=22, bordermode=OUTSIDE, height=20, width=60)  

        self.F_dBm_f = tk.Label(self, text='(00.0dBm) ', font=('Helvetica', 9, 'bold'),anchor="w", pady=2, width=9)
        self.F_dBm_f.configure(fg='cyan', bg="black")
        self.F_dBm_f.place(x=354, y=22, bordermode=OUTSIDE, height=20, width=80)  
        
        self.R_Watts_f = tk.Label(self, text='REF:', font=('Helvetica', 12, 'bold'),anchor="e",width=6)
        self.R_Watts_f.configure(font=self.btn_font, pady = 0)        
        self.R_Watts_f.place(x=434, y=22, bordermode=OUTSIDE, height=20, width=40)

        self.R_Watts_a = tk.Label(self, text=' ', font=('Helvetica', 12, 'bold'),anchor="e",width=5)
        self.R_Watts_a.configure(fg='yellow', bg="black", pady = 0)        
        self.R_Watts_a.place(x=477, y=22, bordermode=OUTSIDE, height=20, width=60)

        self.R_dBm_f = tk.Label(self, text='(00.0dBm) ', font=('Helvetica', 9, 'bold'),anchor="w", pady=2, width=9)
        self.R_dBm_f.configure(fg='cyan', bg="black")
        self.R_dBm_f.place(x=537, y=22, bordermode=OUTSIDE, height=20, width=80)

        self.SWR_f = tk.Label(self, text='SWR:', font=('Helvetica', 12, 'bold'),pady=0,anchor="w",width = 5)
        self.SWR_f.configure(font=self.btn_font)
        self.SWR_f.place(x=626, y=22, bordermode=OUTSIDE, height=20, width=40)

        self.SWR_a = tk.Label(self, text=' ', font=('Helvetica', 12, 'bold'),pady=0,anchor="e",width = 3)
        self.SWR_a.configure(font=self.btn_font)
        self.SWR_a.place(x=666, y=22, bordermode=OUTSIDE, height=20, width=40)
        
        #This label is just a buffer to prevent the SWR value from touching the right edge of a resized window
        self.SWR_s = tk.Label(self, text=' ', font=('Helvetica', 12, 'bold'),pady=0,anchor="e",width = 0)
        self.SWR_s.configure(font=self.btn_font)
        self.SWR_s.place(x=706, y=22, bordermode=OUTSIDE, height=20, width=10)
        #
        #--------------------------------------------------------------------------------------------------
        # Third row if rotator control is enabled
        #
        if ROTOR_ENABLE == 1:
            self.AZ_lbl = tk.Label(self, text='Rotator: ', font=('Helvetica', 12, 'bold'),pady=0,anchor="w",width = 5)
            self.AZ_lbl.configure(font=self.btn_font)
            self.AZ_lbl.place(x=10, y=44, bordermode=OUTSIDE, height=20, width=60)

            self.AZ = tk.Label(self, text=' ', font=('Helvetica', 12, 'bold'),anchor="w", width=7)
            self.AZ.configure(fg='light green', bg="black", pady = 0)          
            self.AZ.place(x=65, y=44, bordermode=OUTSIDE, height=20, width=352)  
            
            b_x = 422
            b_width = 38
            self.rotorCCW = tk.Button(self)
            self.rotorCCW["text"] = "CCW"
            self.rotorCCW["command"] = self.rotor_CCW  # Jump to Band X
            self.rotorCCW.configure(fg='black',font=self.btn_font, padx=1, state='normal')
            self.rotorCCW.place(x=b_x, y=44, bordermode=OUTSIDE, height=20, width=b_width) 

            b_x += b_width
            self.rotorCW = tk.Button(self)
            self.rotorCW["text"] = "CW"
            self.rotorCW["command"] = self.rotor_CW  # Jump to Band X
            self.rotorCW.configure(fg='black',font=self.btn_font, padx=1, state='normal')
            self.rotorCW.place(x=b_x, y=44, bordermode=OUTSIDE, height=20, width=b_width) 
    
            b_x += b_width
            b_width = 40  
            self.rotor_stop = tk.Button(self)
            self.rotor_stop["text"] = "STOP"
            self.rotor_stop["command"] = self.rotor_STOP  # Jump to Band X
            self.rotor_stop.configure(fg='black',font=self.btn_font, padx=1, state='normal')
            self.rotor_stop.place(x=b_x, y=44, bordermode=OUTSIDE, height=20, width=b_width) 
            
            b_x += b_width
            b_width = 20
            self.rotor_Preset_1 = tk.Button(self)
            self.rotor_Preset_1["text"] = "1"
            self.rotor_Preset_1["command"] = lambda: self.rotor_Preset("1")  # Jump to Band X
            self.rotor_Preset_1.configure(fg='black',font=self.btn_font, padx=1, state='normal')
            self.rotor_Preset_1.place(x=b_x, y=44, bordermode=OUTSIDE, height=20, width=b_width) 
        
            b_x += b_width
            self.rotor_Preset_2 = tk.Button(self)
            self.rotor_Preset_2["text"] = "2"
            self.rotor_Preset_2["command"] = lambda: self.rotor_Preset("2")  # Jump to Band X
            self.rotor_Preset_2.configure(fg='black',font=self.btn_font, padx=1, state='normal')
            self.rotor_Preset_2.place(x=b_x, y=44, bordermode=OUTSIDE, height=20, width=b_width) 

            b_x += b_width       
            self.rotor_Preset_3 = tk.Button(self)
            self.rotor_Preset_3["text"] = "3"
            self.rotor_Preset_3["command"] = lambda: self.rotor_Preset("3")  # Jump to Band X
            self.rotor_Preset_3.configure(fg='black',font=self.btn_font, padx=1, state='normal')
            self.rotor_Preset_3.place(x=b_x, y=44, bordermode=OUTSIDE, height=20, width=b_width) 
        
            b_x += b_width
            self.rotor_Preset_4 = tk.Button(self)
            self.rotor_Preset_4["text"] = "4"
            self.rotor_Preset_4["command"] = lambda: self.rotor_Preset("4")  # Jump to Band X
            self.rotor_Preset_4.configure(fg='black',font=self.btn_font, padx=1, state='normal')
            self.rotor_Preset_4.place(x=b_x, y=44, bordermode=OUTSIDE, height=20, width=b_width) 
        
            b_x += b_width
            self.rotor_Preset_5 = tk.Button(self)
            self.rotor_Preset_5["text"] = "5"
            self.rotor_Preset_5["command"] = lambda: self.rotor_Preset("5")  # Jump to Band X
            self.rotor_Preset_5.configure(fg='black',font=self.btn_font, padx=1, state='normal')
            self.rotor_Preset_5.place(x=b_x, y=44, bordermode=OUTSIDE, height=20, width=b_width) 
        
            b_x += b_width
            self.rotor_Preset_6 = tk.Button(self)
            self.rotor_Preset_6["text"] = "6"
            self.rotor_Preset_6["command"] = lambda: self.rotor_Preset("6")  # Jump to Band X
            self.rotor_Preset_6.configure(fg='black',font=self.btn_font, padx=1, state='normal')
            self.rotor_Preset_6.place(x=b_x, y=44, bordermode=OUTSIDE, height=20, width=b_width) 
        
            b_x += b_width
            self.rotor_Preset_7 = tk.Button(self)
            self.rotor_Preset_7["text"] = "7"
            self.rotor_Preset_7["command"] = lambda: self.rotor_Preset("7")  # Jump to Band X
            self.rotor_Preset_7.configure(fg='black',font=self.btn_font, padx=1, state='normal')
            self.rotor_Preset_7.place(x=b_x, y=44, bordermode=OUTSIDE, height=20, width=b_width) 
        
            b_x += b_width
            self.rotor_Preset_8 = tk.Button(self)
            self.rotor_Preset_8["text"] = "8"
            self.rotor_Preset_8["command"] = lambda: self.rotor_Preset("8")  # Jump to Band X
            self.rotor_Preset_8.configure(fg='black',font=self.btn_font, padx=1, state='normal')
            self.rotor_Preset_8.place(x=b_x, y=44, bordermode=OUTSIDE, height=20, width=b_width) 
            
            self.rotor_STOP()
      
        self.update_label() 
        #time.sleep(0.001)

    # Update GUI text fields with Serial Data from power meter and maybe other places later 
    def update_label(self):
        global restart_serial    
        global own_call    
        global heartbeat_timer
        global last_freq
        global meter_data
        global myRig_meter_ID
        global myRig
        global rotor_data
        global TX_Status

        if own_call == "":     # allow for running without serial port to meter connection, network still running 
            #ID = "NA"       # No ID available from any source
            ID = meter_data[0]
        elif myRig_meter_ID == meter_data[0]:     #  Assign myRig1 to ID 101.  Allow for future case to monitor multiple meters
            ID = myRig               
        elif heartbeat_timer < 200:        # updates every update cycle per .after setpoint.  Typical every 1/4 second.
            ID = own_call   # put something interesting up if network on.
            if heartbeat_timer == 199:      # set to at least 1 less than the if test above
                print(" * WSJ-TX Heartbeat_timer expiring at {}" .format(heartbeat_timer))     # post up the event for FYI
                own_call = ""
                last_freq = ""          # reset when no valid data arriving
            heartbeat_timer += 1        # increment Watchdog counter. Itis reset with every heartbeat received message in WSJTX_Decode thread.
        else:
            ID = meter_data[0]
        self.meter_id_f.configure(text='{0:11s}' .format(ID), width=6) 
        
        if TX_Status == "1":    # Flip the Radio Label to Red during Transmit, grey on RX.
            self.meter_id_l.configure(bg="red")
        else:
            self.meter_id_l.configure(bg="grey94")
        
        curr_band = meter_data[2]
        if curr_band == "":         # if blank then the meter is disconnected or turned off.  Instead post up WSJTX data if avaialble            
            curr_band = last_freq  
            self.band_f.configure(text='%7s Net' % curr_band, anchor="e", fg="cyan",bg="black", pady=1, width=7)  # band Value
        else:
            self.band_f.configure(text='%7s' % curr_band, anchor="e", fg="yellow",bg="black", pady=1, width=7)  # band Value

        self.F_Watts_f.configure(text=' FWD:', anchor="w", width=5)               
        self.R_Watts_f.configure(text='  REF:', anchor="w", width=5)        
        
        if curr_band != "HF":       #  HF band is a "dummy" band to show it is not active 
            # Place "NA" in the power fields because sensors are not used or not connected (Band decoder role only).
            if (HIDE_POWER_INFO != 0):   # Only show Ref Power when HIDE is 0
                self.R_Watts_a.configure(text='  NA  ', width=6)
            else:
                self.R_Watts_a.configure(text='{0:6.1f}W' .format(meter_data_fl[6]), width=6)    
            
            if (HIDE_POWER_INFO < 2):   #  Only show Fwd Power when HIDE is 0 or 1
                if meter_data_fl[5] < 1.0:
                    meter_data_fl[5] = meter_data_fl[6] = 0.0  # zero out values less then minimum detectable by meter
                    meter_data[3] =  meter_data[4] = '0.0'   # also do the dBm values               
                    self.F_Watts_a.configure(text='{0:4.1f}W' .format(meter_data_fl[5]), width=7)                        
                elif meter_data_fl[5] > 9999:   # limit to under 10KW (9999.1W)
                    self.F_Watts_a.configure(text='*OVER* ', width=7)              
                elif meter_data_fl[5] > 99.9:
                    self.F_Watts_a.configure(text='{0:4.0f}W' .format(meter_data_fl[5]), width=7)      
                else:
                    self.F_Watts_a.configure(text='{0:4.1f}W' .format(meter_data_fl[5]), width=7)    
                #self.R_Watts_a.configure(text='{0:6.1f}W' .format(meter_data_fl[6]), width=6)    
            else:    # Place "NA" in the power fields because sensors are not used or not connected (Band decoder role only).
                self.F_Watts_a.configure(text='   NA  ', width=7)
                
            self.F_dBm_f.configure(text='(%6sdBm)' % meter_data[3], anchor="e")
            self.R_dBm_f.configure(text='(%6sdBm)' % meter_data[4], anchor="e")
            self.hv_a.configure(text='%4s' % meter_data2[2], anchor="e")
            self.v14_a.configure(text='%4s' % meter_data2[3], anchor="e")
            self.curr_a.configure(text='%4s' % meter_data2[4], anchor="e") 
            self.temperature_a.configure(text='%4sF' % meter_data2[5], anchor="e")            

        else:           
            self.F_Watts_a.configure(text='   NA  ', width=7)
            self.F_dBm_f.configure(text='(     dBm)', anchor="e")  
            self.R_Watts_a.configure(text='  NA  ', width=6)
            self.R_dBm_f.configure(text='(     dBm)', anchor="e")  
            self.hv_a.configure(text='%4s' % meter_data2[2], anchor="e")
            self.v14_a.configure(text='%4s' % meter_data2[3], anchor="e")
            self.curr_a.configure(text='%4s' % meter_data2[4], anchor="e") 
            self.temperature_a.configure(text='%4sF' % meter_data2[5], anchor="e")

        swr = meter_data_fl[7]
        if swr ==  0.0 or HIDE_POWER_INFO != 0:
            self.SWR_a.configure(text='NA  ',font=('Helvetica', 12, 'bold'), bg="grey94", fg="black", width=4)   # not transmitting
        else:       
            if swr > 9.9:
                self.SWR_a.configure(text='OVR', font=('Helvetica', 12, 'bold'), bg="red", fg="black", width=4)      
            elif swr > 3.0:
                self.SWR_a.configure(text='{0:4.1f}  ' .format(swr), font=('Helvetica', 12, 'bold'), bg="red", fg="black", width=4) 
            else:
                self.SWR_a.configure(text='{0:4.1f}  ' .format(swr), font=('Helvetica', 12, 'bold'), bg="light green", fg="black", width=4) 

        if ROTOR_ENABLE == 1:
            self.AZ.configure(text='{} deg    {}' .format(rotor_data[10], rotor_action[0]), anchor="w")
            #self.AZ_action.configure(text='{}W' .format(rotor_action), width=6)


        if cmd_flag == 1:  # Coupler cal is in progress.             
            self.scale.configure(font=self.btn_font, bg="red",)    
        if cmd_flag == 0:  # Coupler cal is finished.
            self.scale.configure(font=self.btn_font, bg="grey94")

        # check if the serial is open and update button to warn user if it is closed and not supposed to be
        if restart_serial:
            self.comm()
            self.QUIT.configure(fg='white', bg="red")             
            restart_serial = 0   

        self.meter_id_f.after(200, self.update_label)  # refresh the live data display in the GUI window
    
    # These functions are called by a button to do something with the power meter such as change cal sets for a new band

    def get_cal_table(self):
        rx = Send_Mtr_Cmds()
        print("Get the meter's calibation table")
        # Write command to change meter scale and change meter face to Watts
        rx.send_meter_cmd("252", "", True)          # Direct Cm is True to send the 2 bytes out direct.  WSJTX calls with False set.
        #rx.send_meter_cmd("247", "1", True)          # 192 is Disable WD to cause reset in 50 seconds
       
    def change_band(self):
        rx = Send_Mtr_Cmds()
        #print("Go to Next Band ")
        print("Reset via Watchdog Timeout 45sec")
        # Write command to change Band
        #rx.send_meter_cmd("254","", True)
        # Temp command to stop watchdog timer and cause a power cycle
        rx.send_meter_cmd("192","1", True)

    def Toggle_UDP_data_out(self): 
        rx = Send_Mtr_Cmds()
        print("Toggle UDP Power and Voltage Data output stream")
        # Write command to change meter face to SWR
        rx.send_meter_cmd("52","2", True)

    def enable_ENET(self):
        rx = Send_Mtr_Cmds()
        print("Toggle Ethernet ON/OFF")
        # Write command to slow data rate output from meter
        rx.send_meter_cmd("53","2", True)
        
    def band_10g(self):
        rx = Send_Mtr_Cmds()
        print("Jump to 10GHz Band ")
        # Write command to jump to band 9
        rx.send_meter_cmd("194","", True)
        
    def band_5700(self):
        rx = Send_Mtr_Cmds()
        print("Jump to 5.7GHz Band ")
        # Write command to jump to band 8
        rx.send_meter_cmd("193","", True)
        
    def band_3400(self):
        rx = Send_Mtr_Cmds()
        print("Jump to 3.4GHz Band ")
        # Write command to jump to band 7
        rx.send_meter_cmd("195","", True)
        
    def band_2300(self):
        rx = Send_Mtr_Cmds()
        print("Jump to 2.3GHz Band ")
        # Write command to jump to band 6
        rx.send_meter_cmd("247","", True)
        
    def band_1296(self):
        rx = Send_Mtr_Cmds()
        print("Jump to 1296MHz Band ")
        # Write command to jump to band 5
        #rx.send_meter_cmd("246","", True)
        rx.send_meter_cmd("246","", True)
        
    def band_902(self):
        rx = Send_Mtr_Cmds()
        print("Jump to 902MHz Band ")
        # Write command to jump to band 4
        rx.send_meter_cmd("245","", True)

    def band_432(self):
        rx = Send_Mtr_Cmds()
        print("Jump to 432MHz Band ")
        # Write command to jump to band 3
        rx.send_meter_cmd("244","", True)

    def band_222(self):
        rx = Send_Mtr_Cmds()
        print("Jump to 222MHz Band ")
        # Write command to jump to band 2
        rx.send_meter_cmd("243","", True)

    def band_144(self):
        rx = Send_Mtr_Cmds()
        print("Jump to 144MHz Band ")
        # Write command to jump to band 1
        rx.send_meter_cmd("242","", True)
    
    def band_50(self):
        rx = Send_Mtr_Cmds()
        print("Jump to 50MHz Band ")
        # Write command to jump to band 0
        rx.send_meter_cmd("241","", True)
    
    def band_10(self):
        rx = Send_Mtr_Cmds()
        print("Jump to 28MHz Band ")
        # Write command to jump to band 0
        rx.send_meter_cmd("240","", True)
        
    def band_12(self):
        rx = Send_Mtr_Cmds()
        print("Jump to 24MHz Band ")
        # Write command to jump to band 0
        rx.send_meter_cmd("239","", True)
    
    def band_15(self):
        rx = Send_Mtr_Cmds()
        print("Jump to 21MHz Band ")
        # Write command to jump to band 0
        rx.send_meter_cmd("238","", True)
        
    def band_17(self):
        rx = Send_Mtr_Cmds()
        print("Jump to 18MHz Band ")
        # Write command to jump to band 0
        rx.send_meter_cmd("237","", True)    
        
    def band_20(self):
        rx = Send_Mtr_Cmds()
        print("Jump to 14MHz Band ")
        # Write command to jump to band 0
        rx.send_meter_cmd("236","", True)
        
    def band_30(self):
        rx = Send_Mtr_Cmds()
        print("Jump to 10MHz Band ")
        # Write command to jump to band 0
        rx.send_meter_cmd("235","", True)
            
    def band_40(self):
        rx = Send_Mtr_Cmds()
        print("Jump to 7MHz Band ")
        # Write command to jump to band 0
        rx.send_meter_cmd("234","", True)
            
    def band_60(self):
        rx = Send_Mtr_Cmds()
        print("Jump to 5MHz Band ")
        # Write command to jump to band 0
        rx.send_meter_cmd("233","", True)    
    
    def band_80(self):
        rx = Send_Mtr_Cmds()
        print("Jump to 3.5MHz Band ")
        # Write command to jump to band 0
        rx.send_meter_cmd("232","", True)
        
    def band_160(self):
        rx = Send_Mtr_Cmds()
        print("Jump to 1.8MHz Band ")
        # Write command to jump to band 0
        rx.send_meter_cmd("231","", True)
        
    def band_HF(self):
        rx = Send_Mtr_Cmds()
        print("Jump to HF (Generic) Band ")
        # Write command to jump to band 0
        rx.send_meter_cmd("230","", True)

    def rotor_CCW(self):
        print("Move rotor CCW up to limits")
        global send_rotor_cmd_flag
        global rotor_cmd
        global rotor_cmd_data
        send_rotor_cmd_flag = True
        rotor_cmd = "230"
        rotor_cmd_data = ""

    def rotor_CW(self):
        print("Move rotor CCW up to limits")
        global send_rotor_cmd_flag
        global rotor_cmd
        global rotor_cmd_data
        send_rotor_cmd_flag = True
        rotor_cmd = "231"
        rotor_cmd_data = ""

    def rotor_CCW_GOTO(self):
        print("Move rotor CCW up to heading")
        global send_rotor_cmd_flag
        global rotor_cmd
        global rotor_cmd_data 
        send_rotor_cmd_flag = True       
        rotor_cmd = "240"
        rotor_cmd_data = "40"
    
    def rotor_CW_GOTO(self):
        print("Move rotor CCW up to heading")
        global send_rotor_cmd_flag
        global rotor_cmd
        global rotor_cmd_data 
        send_rotor_cmd_flag = True               
        rotor_cmd = "241"
        rotor_cmd_data = "165"
        
    def rotor_Preset(self, preset_num):
        print("Move rotor to Preset (0-9)")
        global send_rotor_cmd_flag
        global rotor_cmd
        global rotor_cmd_data  
        send_rotor_cmd_flag = True              
        rotor_cmd = "254"
        rotor_cmd_data = preset_num
    
    def rotor_STOP(self):        
        print("STOP rotor")
        global send_rotor_cmd_flag
        global rotor_cmd
        global rotor_cmd_data  
        send_rotor_cmd_flag = True              
        rotor_cmd = "242"
        rotor_cmd_data = ""

    def comm(self):         # toggle Serial port (only) if on or off, do noting if neither (started up with out a serial port for example)
        global comms
        global meter_data
        global meter_data_fl
        global meter_sock

        if comms == True:
            # Closing comms   - do not call this if they are already off!
            comms = False
            self.QUIT.configure(text = format("Off"))
            self.QUIT.configure(fg='black', bg="light grey")           
            self.serial_rx.stop()
            self.serial_rx.join()
            self.serial_rx = None
            #  Zero Out Serial Data
            for i in range(len(meter_data)):
                meter_data[i] = ""
                meter_data_fl[i] = 0
            print(" Serial thread stopped ")
        elif comms == False:
            comms = True
            self.QUIT.configure(text = format("On"))
            self.QUIT.configure(fg="black", bg="green")
            self.serial_rx = Serial_RxTx()
            self.serial_rx.start() 
            print(" Serial thread started ")
        elif comms == None:         # ethernet option to serial.  UDP_Meter or Serial, only one should be enabled at a time.
            print(" main loop starting up UDP!")
            self.udp_meter = UDP_Meter()            
            meter_sock = socket.socket(socket.AF_INET, socket.SOCK_DGRAM)  #UDP
            meter_sock.bind(("", PORTNUM_OF_METER_LISTEN))
            meter_sock.settimeout(1.0)
            self.udp_meter.start()
            #pass 
        else:
            print("Serial thread not started")
            #pass
        # Start the WSJTX thread in any case.
        #print(" WSJT-X thread started in comms function
        #self.wsjtx_decode = WSJTX_Decode()      # Start the WSJTx UDP Thread - runs always for now.
        #self.wsjtx_decode.start()      # start the WSJTX_Decode thread now 
        if (ROTOR_ENABLE == 1):
            self.start_UDP_rotor()      # start up Rotator controller thread.
    
    def start_UDP_rotor(self):
        global rotor_sock

        print(" main loop starting up UDP Rotor!")
        self.udp_rotor = UDP_Rotor()            
        rotor_sock = socket.socket(socket.AF_INET, socket.SOCK_DGRAM)  #UDP
        rotor_sock.bind(("", PORTNUM_OF_ROTOR_LISTEN))
        rotor_sock.settimeout(1.0)
        self.udp_rotor.start()

    def NewFile(self):
        print("New File!")

    def OpenFile(self):
        name = askopenfilename()
        print(name)

    def About(self):
        print(version_string)
        abt = tk.Tk()      
        #   Later improve to save config file and remember the last position 
        screen_width = abt.winfo_screenwidth()
        screen_height = abt.winfo_screenheight()                
        w = 700   # width of our app window
        h = 200   # height of our app window
        x = screen_width/3
        y = screen_height/4
        print('Window size and placement is %dx%d+%d+%d' % (w, h, x, y))
        abt.title("Remote RF Wattmeter Desktop Companion")
        abt.geometry('%dx%d+%d+%d' % (w, h, x, y))
        self.abt_label = tk.Label(abt, text="{}\n\n More info @ {}\n\nIncludes portions of work from {} and\n{}" .format(version_string, my_git_site, nextion_git_site, pywsjtx_git_site),font=('Helvetica', 10, 'bold'), bg="grey94", fg="black")
        self.abt_label.place(x=60, y=0)

    def mainloop(self, *args):
        # Overriding mainloop so that we can do cleanup of our threads
        # *If* any arguments were provided, we would pass them on to Tk.frame
        super().mainloop(*args)
        global comms
        # When main loop finishes, shutdown Serial_RxTx and UDP and WSJTX threads if necessary
        if self.serial_rx:
            self.serial_rx.stop()
            print("Stopping Serial Thread")
        #if self.wsjtx_decode:
        #    self.wsjtx_decode.stop()
        #    print("Stopping WSJT-X Thread")
        if self.udp_meter:
            self.udp_meter.stop()
            print("Stopping UDP Meter Network Thread")
        if self.udp_rotor:
            self.udp_rotor.stop()
            print("Stopping UDP Rotator Network Thread")

    def start_cfg(self):
        Cfg_Mtr()
        print(" ---->  Started Config Window")    
        
    def start_table_cfg(self):
        Table_Cfg_Mtr()
        print(" ---->  Started Table Config Window")

    def start_cfg_rtr(self):
        Cfg_Rtr()
        print(" ---->  Started Rotator Config Window")   
#
#
#-------------------------------------- Rotator Configuration Window ---------------------------------------------
#
class Cfg_Rtr(tk.Frame):      
#    def __init__(self):
        # Call superclass constructor
#        super().__init__()   
    def __init__(self, master=None): 
        # Call superclass constructor
        super().__init__(master) 
        self.Cfg_Rtr_Window()
        self.master.protocol("WM_DELETE_WINDOW", self.exit_protocol) 

    def exit_protocol(self):
        # Will be called when the main window is closed
        #self.after_cancel(update_cfg_win_callback)  
        self.master.destroy()  # Destroy root window
        self.master.quit()  # Exiting the main loop

    def Cfg_Rtr_Window(self):   
        #global xxx
               
        print("Config Screen Goes Here")
        rtr_cfg = tk.Tk()      
        #   Later improve to save config file and remember the last position 
        screen_width = rtr_cfg.winfo_screenwidth()
        screen_height = rtr_cfg.winfo_screenheight()                
        w = 1000   # width of our app window
        h = 940   # height of our app window
        x = screen_width/3
        y = screen_height/30
        print('Window size and placement is %dx%d+%d+%d' % (w, h, x, y))
        rtr_cfg.title("Remote Rotator Configuration Editor")
        rtr_cfg.geometry('%dx%d+%d+%d' % (w, h, x, y))
        self.Rtr_Cfg_Band_label = tk.Label(rtr_cfg, text="Current AZ Rotor position is {}" .format(rotor_data[0]),font=('Helvetica', 18, 'bold'), bg="grey94", fg="black")
        self.Rtr_Cfg_Band_label.place(x=310, y=0)
        #time.sleep(0.1)
#
#
#---------------------------  Wattmeter and Band Decoder Configuration Table Editor Window----------------------------------------
#
class Table_Cfg_Mtr(tk.Frame):      
    global update_table_cfg_win_callback
#    def __init__(self):
        # Call superclass constructor
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
