K7MDL2/RF-Power-Meter-V1/RF_Wattmeter_Teensy41_PCB_V1/nextion_patched/ITEADLIB_Arduino_Nextion_patched/NexNumber.cpp

/**
 * @file NexNumber.cpp
 *
 * The implementation of class NexNumber. 
 *
 * @author  huang xianming (email:<xianming.huang@itead.cc>)
 * @date    2015/8/13
 * @copyright 
 * Copyright (C) 2014-2015 ITEAD Intelligent Systems Co., Ltd. \n
 * This program is free software; you can redistribute it and/or
 * modify it under the terms of the GNU General Public License as
 * published by the Free Software Foundation; either version 2 of
 * the License, or (at your option) any later version.
 */
#include "NexNumber.h"

NexNumber::NexNumber(uint8_t pid, uint8_t cid, const char *name)
    :NexTouch(pid, cid, name)
{
}

bool NexNumber::getValue(uint32_t *number)
{
    String cmd = String("get ");
    cmd += getObjName();
    cmd += ".val";
    sendCommand(cmd.c_str());
    return recvRetNumber(number);
}

bool NexNumber::setValue(uint32_t number)
{
    char buf[10] = {0};
    String cmd;
    
    utoa(number, buf, 10);
    cmd += getObjName();
    cmd += ".val=";
    cmd += buf;
    sendCommand(cmd.c_str());
    return recvRetCommandFinished();
}

uint32_t NexNumber::Get_background_color_bco(uint32_t *number)
{
    String cmd;
    cmd += "get ";
    cmd += getObjName();
    cmd += ".bco";
    sendCommand(cmd.c_str());
    return recvRetNumber(number);
}

bool NexNumber::Set_background_color_bco(uint32_t number)
{
    char buf[10] = {0};
    String cmd;
    
    utoa(number, buf, 10);
    cmd += getObjName();
    cmd += ".bco=";
    cmd += buf;
    sendCommand(cmd.c_str());
	
    cmd="";
    cmd += "ref ";
    cmd += getObjName();
    sendCommand(cmd.c_str());
    return recvRetCommandFinished();
}

uint32_t NexNumber::Get_font_color_pco(uint32_t *number)
{
    String cmd;
    cmd += "get ";
    cmd += getObjName();
    cmd += ".pco";
    sendCommand(cmd.c_str());
    return recvRetNumber(number);
}

bool NexNumber::Set_font_color_pco(uint32_t number)
{
    char buf[10] = {0};
    String cmd;
    
    utoa(number, buf, 10);
    cmd += getObjName();
    cmd += ".pco=";
    cmd += buf;
    sendCommand(cmd.c_str());
	
    cmd = "";
    cmd += "ref ";
    cmd += getObjName();
    sendCommand(cmd.c_str());
    return recvRetCommandFinished();
}

uint32_t NexNumber::Get_place_xcen(uint32_t *number)
{
    String cmd;
    cmd += "get ";
    cmd += getObjName();
    cmd += ".xcen";
    sendCommand(cmd.c_str());
    return recvRetNumber(number);
}

bool NexNumber::Set_place_xcen(uint32_t number)
{
    char buf[10] = {0};
    String cmd;
    
    utoa(number, buf, 10);
    cmd += getObjName();
    cmd += ".xcen=";
    cmd += buf;
    sendCommand(cmd.c_str());
	
    cmd = "";
    cmd += "ref ";
    cmd += getObjName();
    sendCommand(cmd.c_str());
    return recvRetCommandFinished();
}

uint32_t NexNumber::Get_place_ycen(uint32_t *number)
{
    String cmd;
    cmd += "get ";
    cmd += getObjName();
    cmd += ".ycen";
    sendCommand(cmd.c_str());
    return recvRetNumber(number);
}

bool NexNumber::Set_place_ycen(uint32_t number)
{
    char buf[10] = {0};
    String cmd;
    
    utoa(number, buf, 10);
    cmd += getObjName();
    cmd += ".ycen=";
    cmd += buf;
    sendCommand(cmd.c_str());
	
    cmd = "";
    cmd += "ref ";
    cmd += getObjName();
    sendCommand(cmd.c_str());
    return recvRetCommandFinished();
}

uint32_t NexNumber::getFont(uint32_t *number)
{
    String cmd;
    cmd += "get ";
    cmd += getObjName();
    cmd += ".font";
    sendCommand(cmd.c_str());
    return recvRetNumber(number);
}

bool NexNumber::setFont(uint32_t number)
{
    char buf[10] = {0};
    String cmd;
    
    utoa(number, buf, 10);
    cmd += getObjName();
    cmd += ".font=";
    cmd += buf;
    sendCommand(cmd.c_str());

    cmd = "";
    cmd += "ref ";
    cmd += getObjName();
    sendCommand(cmd.c_str());
    return recvRetCommandFinished();
}

uint32_t NexNumber::Get_number_lenth(uint32_t *number)
{
    String cmd;
    cmd += "get ";
    cmd += getObjName();
    cmd += ".lenth";
    sendCommand(cmd.c_str());
    return recvRetNumber(number);
}

bool NexNumber::Set_number_lenth(uint32_t number)
{
    char buf[10] = {0};
    String cmd;
    
    utoa(number, buf, 10);
    cmd += getObjName();
    cmd += ".lenth=";
    cmd += buf;
    sendCommand(cmd.c_str());

    cmd = "";
    cmd += "ref ";
    cmd += getObjName();
    sendCommand(cmd.c_str());
    return recvRetCommandFinished();
}

uint32_t NexNumber::Get_background_crop_picc(uint32_t *number)
{
    String cmd;
    cmd += "get ";
    cmd += getObjName();
    cmd += ".picc";
    sendCommand(cmd.c_str());
    return recvRetNumber(number);
}

bool NexNumber::Set_background_crop_picc(uint32_t number)
{
    char buf[10] = {0};
    String cmd;
    
    utoa(number, buf, 10);
    cmd += getObjName();
    cmd += ".picc=";
    cmd += buf;
    sendCommand(cmd.c_str());
	
    cmd = "";
    cmd += "ref ";
    cmd += getObjName();
    sendCommand(cmd.c_str());
    return recvRetCommandFinished();
}

uint32_t NexNumber::Get_background_image_pic(uint32_t *number)
{
    String cmd = String("get ");
    cmd += getObjName();
    cmd += ".pic";
    sendCommand(cmd.c_str());
    return recvRetNumber(number);
}

bool NexNumber::Set_background_image_pic(uint32_t number)
{
    char buf[10] = {0};
    String cmd;
    
    utoa(number, buf, 10);
    cmd += getObjName();
    cmd += ".pic=";
    cmd += buf;
    sendCommand(cmd.c_str());
	
    cmd = "";
    cmd += "ref ";
    cmd += getObjName();
    sendCommand(cmd.c_str());
    return recvRetCommandFinished();
}
