K7MDL2/RF-Power-Meter-V1/(commit log)

2020-04-27 Add files via upload
    Initial V1.00 Upload for RF Power Meter Arduino Meter and for Python Remote Power Meter app
2020-04-28 Fixed Hang on serial port garbage from CPU resets
    [simple_server.py]
2020-04-28 Add Remote Power App Screen shot
2020-04-29 Arduino Setup
2020-04-29 Correcting Arduino File Name Format
2020-04-29 Tuning upload filters
2020-05-03 Partial work Serial Port Error handlng on Fault and Startup
    [pyRFPowerMeter.py]
2020-05-03 Serial port validation and prompting for missing com port choice implemented on program startup
    [pyRFPowerMeter.py]
2020-05-03 Turns off comms threads if serial port access fails. Can turn back on with On/Off button once problem resolved.
    [pyRFPowerMeter.py]
2020-05-03 Network thread will alway runs, no on/off anymore
2020-05-03 Change Radio ID and Band to fail over to WSJTX source when no serial data available. Band = 'band Net', Radio ID = Callsign. NA and Band="" when no sources
    [pyRFPowerMeter.py]
2020-05-03 Remove debug print line
2020-05-07 Arduino side updates for serial error handlng and A/D factory cal data used now.
2020-05-09 Updated for work on 5/8, mostly on headless changes in new RF_Wattmeter.ino new file addition.
    Working with a few renamed test buttons in the GUI. Still needs GUI expansion work to support editing and saving cal sets to a file.
2020-05-10 Point to current release .zip. for V1.01
    V1.02 and the Master branches have more current features and will work fine but does have some changes to facilitate testing new features like some GUI button redefinitions from V1.02 work. Overall the bulk of serial port handling changes are a benefit of trying a newer release.
2020-05-10 Initial headless operation on Nano is working with CPU reset on the 3.4G button, Default EEPROM on sequence of 5.7G and 10G buttons. No ADC Vref cal yet.
    [pyRFPowerMeter.py]
2020-05-10 Create RF_Nano_Headless.ino
    Stripped out all M5Stack and ESP32 dependencies, no screen or buttons, tartgeted at the Nano since that is what I have here. Can measure VCC to help with lack of stable Vref > 1.1V but this wil likely require external well regulated Vref on the AREF pin.
    This release of the Desktop GUI has several buttons remappped to gove test commands. 3.4G is CPU reset, 5.7G and 10G in sequence wil erate EPEROM byte 0. Folow that with a CPU reset and you reset the EEPROM t default values. Other buttons retrieve the cal table and schange cal values for test.
    [RF_Nano_Headless.ino]
2020-05-10 Catch serial decode error from CPU reset
    [pyRFPowerMeter.py]
2020-05-10 Multiple meter support wih Cmd line arg for MeterID, serial port error handing fix.
    [RF_Nano_Headless.ino, pyRFPowerMeter.py]
2020-05-10 Updatd for latest changes, Arduino Nano support, monitor multiple meters
2020-05-16 Fixed crash on serial command with no ',' separators or too short
    [RF_Power_Meter.ino]
2020-05-16 Removed output couter and flow rate commands
2020-05-16 ADC smoothing mod, added 0.01 cap to M5 ADC inputs
2020-05-16 ADC cal tweaks
2020-05-23 Updated cal table for my actual coupler values
2020-05-28 Adding PSoC5LP Headless Version files
    Ported Nano Headless to Cypress Semiconductors PSoC5LP CY8CKIT-059 dev module. Just a bit larger then a NAno, tons more IO and programmable analog and digital components on chip. Full EEPROM and high quality 16-20 Bit resolution DeltaSigma ADC with on chip op amp bufffering and scaling.
2020-05-31 Fixed EEPROM Read, Optimized Cal & ADC Fwd and Ref
    [pyRFPowerMeter.py]
2020-05-31 Fixed EEPROM, Optimized ADC Cal
    Fixed problem not reading EEPROM value back into memory, Now when a coupling value is changed it is used immediately, ADC cal and offset tuned for particular AD8318 modules. Now have no avergaing or fudge factor, coupling values are very close to coupler printed cal chart values. Adjusted offset voltage value to better match actual nwo that the ADC is more accurate than was for the Arduino boards. Added SSD1306 controller based OLED support files and code rady for testing a msall OLED 128x64 display inteneded for embedding into a high power RF amplifier.
2020-05-31 Added update for SSSD1306 OLED controller code add, ADC cal perf, and EEPROM read fix, all on the PSoC version.
2020-06-03 PSoC - fix to oeprate without USB, 128x64 OLED.
    [pyRFPowerMeter.py]
2020-06-09 Remapped buttons to allow for 11 bands adding HF
2020-06-17 Changes to support auto calibration using 2 power levels
2020-06-17 ADS1100 external I2C connected 16bit ADC assigned to Forward port for testing. Works good.
    Need to wire a test another ADS1100 unit for the Ref channel. Far better than the internal ADCs.
2020-06-20 improved error handling in startup
    [pyRFPowerMeter.py]
2020-06-22 Factory Reset button in Config Screen now working
2020-06-25 Updated PSoC to match new 3.5" Nextion Display. Added dBm & Power Graphing page to display, Added 2.4" Nextion File.
    With larger 3.5" display added SWR and Fwd and Ref Power graphs, dbm in the power. In the PSoC have auto calibrate using 2 power levels, one high and one low to calculate offset and slope. PSoC code has some other tweaks to support the desktop apps new Config window commands.
2020-06-29 Updates for remote Nextion serial line switching, ADL5519 temperature displayed on front screen
    Also when calibrating, removed requirement to get a new hi power reading before doing cal using the low power reading.. Before the low power cal command zeroed the hi power value. Any cal redo required getting both values each time when only 1 or the other are really needed in a single session.
2020-06-30 Config Screen button placement
2020-07-01 Display ADC Voltage to Cfg Window Measure Button
2020-07-01 Added ADC voltages, enforced sequence to measure
2020-07-01 Cmd status message now contains ADC Fwd and Ref Hi and Lo voltage readings taken during cal
2020-07-01 New Volts display in Cfg screen & Cal test results
2020-07-02 Measure in dBm or Watts
    Renumbered Measure and Calculate commands, Now have command for Hi and low power levels in either dBm or Watts. No conversion required at the host. Less error.
2020-07-02 Added radio button for choice of power level entry in dBm or Watts. Uses new commands to send measured value to host for each unit format.
2020-07-25 Quick Band change page, ADC Cal screen
2020-07-27 Added PSoC top Level Schematic Drawing
2020-07-27 Added N1MM+ OTRSP serial control message handling to change bands and control 4 bit BCD Aux ouput pins. These can go to transverfters or Antenna switches. Band numbers set to match RF wattmeter bands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
2020-07-27 N1MM+ OTRSP serial port AUX BCD pin control support added to PSoC version
2020-07-28 Delete RF Wattmeter PSoC5 TopDesign Schematic Drawing V2.2 July 27 2020.JPG
    Moved an updated version to PSoC folder
2020-08-01 Added Aux to Nextion Dispolay, fixed bad Aux Msg msgs and ADC hangs
2020-11-06 Create RF_Wattmeter_PSoC5LP and BCD Band Decoder-000.cywrk.Archive17.zip
    NEw PSoC5 version with enhanced band decoder features and improvments to SWR spikes, optional DAC voltage output representing SWR for embedded RF amplifier control board Hi SWR protection input.
2020-11-07 Nextion 3.5" graph page power scaling fix
    Fixed Nextion Graph page Fwd and Ref Pwr on 3.5" to scale properly after resize from 2.4"
2020-11-07 Fix for Page 3 (pg=3) status so graphs update
    Fixed problem with page 3 status not updating correctly thus not updating the graph page power and swr number values which in turn are used to fill in the graphs.
2020-11-13 Added 1296 amp embedded OLED wattmeter with SWR analog output signal for amp protection
    Built this amp 11/2020 and installed a RF wattmeter assembly with OLED display on the front panel. Uses the PSoC5 KitProg board for a compact solution. Measuring 14V, 28V, ADL5519 detector temp and a DAC with buffer amp was configured to output an analog voltage corresponding to SWR range 1-5. This is wired to the W6PQL Ultimate Amplifier Control Board Load Fail input to trip the amplifier in Hi SWR situation. A current sensor and power reset relay yet to be added.
2020-11-13 Compact OLED RF Wattmeter with SWR voltage output added to front panel of 1296MHz RF Amp
2020-11-17 New v2.3 drawings and a note about voltage manual cal (hardcoded cal).
2020-11-17 Added note about utility of monitoring station power supplies remotely.
2020-11-18 Updated to display voltage, curr and Temp
2020-11-18 Send out new serial message for voltage, current and temp
2020-11-18 Add note about new ability to read voltage, curr and temp on the desktop app.
2020-11-18 Updated desktop App snapshot for V2.3 showing voltage, current and temp numbers.
2020-11-19 Added HIDE or hide as 3rd Arg to command line to hide title frame at startup. Close app using the CMD window.
2020-11-19 Added ability to hide the title frame in the desktop app to save space.
2020-11-22 Moved voltage, current and temp cal factors into EEPROM. Added remote commands 85 to 88 to send cal target values.
    Use Save to Meter button in Desktop Config panel to commit to EEPROM. Manually sending remote command to set values for now until Desktop Config Panel is extended to display a button for each value similar to the Fwd and Ref power fields.
2020-11-22 Added remote commands 85-88 to set voltage current and temp cal values which are now stored in EEPROM.
2020-11-23 Updated notes for Current sensor zero offset with cmd 85 (no args needed).
    cmd 84 is now temp. After a Current offset is measured at no load, do a cmd 86 with a known load.
2020-11-23 Replaced with Archive #25 containing Current Zero Offset addition
2020-11-23 Contains changes to main and rfwattmeter.h to measure and store and use a current sensor zero offset voltage such as required by the ACS712.
2020-11-24 Added Config for Temp, Voltage and Current, Populated About Screen
2020-11-24 Added end note to V2.3 notes about adding Desktop Cal page buttons for Temp, Volts and Curr
    Also filled out the About Page. Still need to add cal buttons to the Nextion pages.
2020-11-24 Added support to calibrate Temp, Voltages and Current
2020-11-25 Tweaked the Current Zero Offset handling to enable ability to trim the value. Before it ignored any UI value supplied.
    The volt, temp and current cal and offset values are only stored with limited precision in EEPROM so range is X.XX. (Stored as a 4 byte ASCII value, not as a number)
    Entering -0.008 for the No Load Current in the Desktop UI Config page bumps up a 0.4A current reading to 0.5A but it can only be stored as -0.01 or 0.00 so the value read after Save to Meter may change. best to only use 2 decimal places max. The minus sign I think is also lost. This will need to be changed later for more precision and to support negative values. Probably store into EEPROM these as 16 bit si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
2020-11-25 Added note about change to how Current_Zero_Offest is handled to allow tweaking the zero offset some.
2020-12-01 Teensy 4.1 ported from latest PS0C5 code 12/1 (working!)
    I ported the PSoC5 latest C code to the Teensy 4.1 Arduino 1.8.13 IDE.
    The PSoC5 version used a modified version of the original Nextion Arduino library converted to C and includes only the most used parts. The Nextion files are placed in the Documents\Arduino\libraries folder.
    The SS1306 OLED files are also in C for the PSoC5 and do not not work on the Arduino as is. The //#define SSD1306_OLED is commented out so it is bypassed for now and only used if you had a OLED connected to the I2C bus.
    Happy to say that is is now working with some issues to tweak and fix still. It will operate 100% it seems without any display using the D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
    [RF_Wattmeter_Arduino.h, RF_Wattmeter_Teensy41.ino]
2020-12-01 Nextion Library (shortened C version for Arduino)
    Install this into your Arduino libraries folder. Usually C:\Documents\Arduino\libraries
    [NexConfig.h, NexHardware.cpp, NexHardware.h, NexNumber.cpp, NexPage.cpp]
2020-12-01 Added V 2.4. Adds new Teensy4.1 port from PSoC5 latest (2.3) version code and supports the Nextion and Desktop app control. No OLED display or band decoder yet.
2020-12-01 Added V 2.4. Adds new Teensy4.1 port from PSoC5 latest (2.3) version code and supports the Nextion and Desktop app control. No OLED display or band decoder yet.
2020-12-02 OTRSP now working (Mostly)
    Still need to make the band decoder output IO pins work and convert the BCD AUX command input to BCD properly. Today is processed as decimal value but it will change the Wattmeter band. The CW and PTT from USB are not functional. If the radio does not change band and you are running WSJTX with the Desktop App, the Desktop will send the meter the current radio band and thus set the Meter to match again. This is the same as changing a the meter band from the touchscreen or the desktop app using the band button. The meter always takes the last command from any source.
2020-12-02 OTRSP and Debugging Missed touchscreen events
    [NexHardware.cpp, RF_Wattmeter_Arduino.h, RF_Wattmeter_Teensy41.ino]
2020-12-04 Switched to Standard Nextion Arduino Library with minor changes
    Switched from the C port used on teh PSoC to the standard Arduino library. Added page detect in NexHardware.cpp nex_listen function to detect pages on the fly from Nav button touch events to reduce traffic and increase accuracy.
2020-12-04 Install this library in your documents/Arduino/libraries folder
    This files is added to the std Nextin library to add project defines.
2020-12-04 Updated status on Teensy Arduino port. Almost all working now.
    Switched to standard Arduino Nextion library with a few mods, improved OTRSP, fixed band decoding part way, and resolved all compiler warnings. Testing looks good so far. OLED and Band Decoding areas still need work rest looks OK.
2020-12-05 Resolved 99% of page sync issues
    If you cycle through the Nextion pages really fast it is possible to miss an event. I think the event is never sent out but the screen changes. The best way to deal with this is to have the CPU make the actual change rather than the current way of the Nextion changing pages for sake iof instant response feel speed and sending out a notice of that change. Placed strategic sendme command retry once on fail to reduce occurance of a page mismatch. Long term will shift to a hidden API page with nothing but global variables and only address those variables from the CPU so always on the same page from the CPU perspective.
    [NexConfig.h, NexHardware.cpp, NexHardware.h, RF_Wattmeter_Arduino.h, RF_Wattmeter_Nextion.h, RF_Wattmeter_Teensy41.ino]
2020-12-05 Swapped to new Arduino library for OLED
    OLED SSD1306 displays should now work but I do not have a display to test with right now. Functions were 1 for 1 swap out.
    [RF_Wattmeter_Arduino.h, RF_Wattmeter_Teensy41.ino]
2020-12-05 Added Arduino on Teensy description to Key Files/Folders section.
2020-12-12 Added full featured Band Decoder functionality
    Now either OTRSP or the 6 Band-Input pins can work to change bands and will send data out 3x 8-bit ports, A, B and C.
    By default port A will mirror the input pins, useful for intercepting a BCD or 1-of-8 Band decoder from a radio on the input port then pass it on through Port A to a stack of transverters, or the Q5 Signal 5-Band transverter.
    2 additional ports of 8 pins can serve amps and antennas or power meter coupler selection.
    A cool feature is the variety of translation modes for every port. Each port generally has 4 translation modes. 1. Transparent
    2. 1-of-8 decode
    3. Custom pattern (per band),
    4. OTRSP value from AUX commands.
    This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
2020-12-12 Added band Decoder Feature
    See detailed notes about the many features supporting OTRSP, one 6 pin Input port and three 8-pin output ports. Still need to create the GUI on the Nextion and Desktop app to configure all of this. Serial config messages 62-69 exist to support this.
2020-12-13 Show current state in Band Decoder Config page
2020-12-14 Fixed pywsjtx path issues
    [pyRFPowerMeter.py, simple_server.py]
2020-12-17 3.3V driver compatibility note on Port driver future work
2020-12-18 Band Decoder PTT with Active HI/LO config
    Have fully working PTT input and PTT Output, each with their own Active High and Active Low settings. I call this polarity. Ports A, B and C also have a new settings that allow them to follow PTT using various modes as a mask to inmdicate whcih bits to raise (Active HI for TX) or lower (Active Low for TX). This is useful for routing PTT to amps or transverters or LNAs.
    Also tested on a SSD1306 OLED today and added a custom screen with #ifdef more suited to band decoder use. Upper areas show active band name, FWD power in Watts and dBm, and SWR. Lower line shows the 4 band decoder ports state in Hex. Band 0 is treated as a dummy band to zero o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
2020-12-18 OLED optimized for Combo Band Decoder + Wattmeter Readout
    This screen is going into a Arduino version RF wattmeter with Band Decoder out in my outdoor boxes where my transverters and amps are located. This meter will ship back the data over a USB extender. Also plan to rout the Nextion serial over a 3rd USB serial port where the desktop app will bridge the data to another PC comm port connected to a local Nextion display via a USB Serial TTL converter in the shack. The Desktop app allows me to operate remote using a Remote Desktop login. The row at the bottom shows input port and the 3 output ports pin state in HEX. Configuration is done today via the Desktop app. See the GitHub projec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
2020-12-18 Updated Band Decoder feature work done today. PTT in and out and PTT Follow Mode on the output ports. Also OLED Decoder/Power Combo screen layout.
2020-12-18 Added remote commands and Desktop App Config Screen Suppprt for PTT Options
    Could use some screen cleanup but what is there works. Once exception is Toggle Serial Data button. It has an issue on the Pythn side so will only send command to turn on data for now. Can manually send 100,120,239,0 in monitor windows to turn off. 100,120,239,1 to turn it back on.
    [RF_Wattmeter_Arduino.h, RF_Wattmeter_Teensy41.ino, pyRFPowerMeter.py]
2020-12-18 Updated text for current status of coding and features
2020-12-18 Changed OLED Watts top line to "OFF" on band 0. Fixed bug where band decoder was not reading input on boot up.
    [RF_Wattmeter_Arduino.h, RF_Wattmeter_Teensy41.ino]
2020-12-19 Rassign pins for wiring convenience
2020-12-20 Pin Chart for Teensy 4.1 build
2020-12-20 Create Teensy 4.1 Band Decoder-Wattmeter CPU board connectorization.jpg
2020-12-20 Moved Nextion to Serial1, Replaced SWR wiith PTT Status on OLED
    [NexConfig.h, RF_Wattmeter_Arduino.h, RF_Wattmeter_Teensy41.ino]
2020-12-21 Updated Teensy 4.1 build info
2020-12-23 Accoun tfor Inverting buffers used in current decoder buildout
    [RF_Wattmeter_Teensy41.ino]
2020-12-23 Notes about buffer inversion correction, PTT2 addition for sequencing, rearranged IO assignments for ease of wiring.
2020-12-23 Cleanup pin assignments and comments.
2020-12-25 Moved to resolve no parent package errors
    [pyRFPowerMeter.py, simple_server.py]
2020-12-30 Added new WSJT-X Arduino Ethernet Message Decoder
    Test program to learn how ethernet on the Teensy 4.1 works, how UDP over ethernet in Arduino works, and how to decode messages form WSJTX and later other programs. Intend to integrate this into the Band Decoder/RF Wattmeter project.
2020-12-30 Added WSJT-X UDP message decode test program (as of V2.3.0-rc2) on Teensy 4.1 over its native ethernet connection.
2020-12-30 Added for Ethernet UDP decode on Arduino Teensy 4.1
2021-01-02 Ethernet now works, Serial can be skipped on start
    [pyRFPowerMeter.py]
2021-01-07 Debuuged Serial and Ethernet issues.
    [pyRFPowerMeter.py]
2021-01-07 Added ADS1115 ADC for RF Pwr and Temp. Fixed Bugs.
    [RF_Wattmeter_Arduino.h, RF_Wattmeter_Teensy41.ino]
2021-01-07 Added ADS1115 external ADC board support, fixed reliability issues with enet and serial comms.
2021-01-08 Fixed program not exiting
    [pyRFPowerMeter.py]
2021-01-12 #ifdef added for ADC poin assignments for ADS1115
2021-01-14 Staged Nextion UDP code, band decoder test fixes
    [RF_Wattmeter_Arduino.h, RF_Wattmeter_Teensy41.ino]
2021-01-14 Reduced some print traffic
2021-01-23 New UDP Rotor program. Nextion remote display TBA
2021-01-23 Simple AZ only remote headless UDP rotator controller for Teensy 4.1. Uses RFWattmeter desktop program for now for remtoe control. More work coming.
2021-01-28 Arduino Rotator Controller Pics Added
2021-01-29 Separated Rotor UDP thread, add test UI for Rotor
2021-01-30 Added dedicated rotor buttons to GUI
2021-01-30 Added ROTATOR_ENABLE & Rotor Config Window frame
2021-01-31 ROTOR_ENABLE set to 1
2021-01-31 Clean up error list, typo in CustomEntry box
    [pyRFPowerMeter.py]
2021-08-04 Prevent band change during TX, Added WD reset cmd.
    [RF_Wattmeter_Teensy41.ino, Rotor-Controller-UDP-Server-RotorHandler.ino, pyRFPowerMeter.py]
2021-08-04 Added cmd 192 for CPU reset via WD timeout (50sec)
    [pyRFPowerMeter.py]
2021-08-10 Removed some errors in UDP threads
    [pyRFPowerMeter.py]
2022-04-10 PCB related changes
2022-04-10 PCB notes
2022-04-10 Support PCB related chancges
    [PowerMeter_BandDecoder_V1.sch]
2022-04-10 Support PCB related changes
2022-04-10 PCB edits
    [PowerMeter_PCBv.02.pcb, PowerMeter_PCBv.03.pcb]
2022-04-10 Reposition edge conbenctors making room for shells
    [PowerMeter_PCBv.03.pcb]
2022-04-10 Corrected ADS1115 to RF detector pin matchup
    [RF_Wattmeter_Teensy41_PCB_V1.h, RF_Wattmeter_Teensy41_PCB_V1.ino]
2022-04-10 Fix Resistor label placement
    [PowerMeter_PCBv.03.pcb]
2022-04-11 12V on Port A+B, WD relay connector
    [PowerMeter_PCBv.04.pcb]
2022-04-11 More PCB related tweaks, Read 12V on PCB
2022-04-11 Rev 0.04 PCB - Testing continues.
2022-04-11 PCB 0.04 and more tweaks, trace short found in J13
2022-04-12 Switched ADC wire1 to Wire, comment typo fixes
    [RF_Wattmeter_Arduino.h, RF_Wattmeter_Teensy41.ino]
2022-04-12 Pic of new PCB V0.01 for RF Wattmeter-Band Decoder
    Here the new board is shown with an optional 3.5" Nextion display. Also uses a small OLED, or no display at all.
2022-04-15 Fixed changes related to PCB hgardweare changes
    [RF_Wattmeter_Teensy41_PCB_V1.h, RF_Wattmeter_Teensy41_PCB_V1.ino]
2022-04-16 Fixed Ethernet 10 minute retry issue.
    [RF_Wattmeter_Teensy41_PCB_V1.h, RF_Wattmeter_Teensy41_PCB_V1.ino]
2022-04-16 Enable remote WD disable cmd to reset.
    [RF_Wattmeter_Teensy41_PCB_V1.ino]
2022-09-09 Fixed Temp factor mult error on read from EEPROM.
    [RF_Wattmeter_Teensy41_PCB_V1.ino]
2022-09-10 During TX, flip Radio label to RED, grey for RX
    [pyRFPowerMeter.py]
2023-02-23 Add sleep timers for threading efficiency
2023-02-23 Optimize thread sleep times
2023-07-03 Fix Host IP address format issue and slow down data ouput
    [RF_Wattmeter_Teensy41_PCB_V1.h, RF_Wattmeter_Teensy41_PCB_V1.ino]
2023-07-03 Minor fix to display Cal Dump Data
    [pyRFPowerMeter.py]
2023-07-03 Update to my current ip address in shack
2023-08-06 Smooth AZ reads, Fix Presets, return values to S-N-S arc
    [Rotor-Controller-UDP-Server-RotorHandler.ino, Rotor-Controller-UDP-Server.h, Rotor-Controller-UDP-Server.ino]
2024-04-12 Add Images for schematic and PCB versions
2024-04-21 Can now run multiple instances for multiple decoders. Disable power fields when sensors not used.
2024-04-21 Let Voltages display while there are no RF power sensors
2024-05-07 Add support for all bands 160M to 3cm. Enable blocking Ref Pwr and SWR When not used
2024-05-08 Testing New Meter Config page for any band 160M to 3cm
2025-02-17 Turn off rcvd msg print to save some CPU
2026-05-13 Update README with Headless-Band-Decoder-Only branch info
    Disable features to leave remote configurable band decoder only that can run on a simple T4.1 or T4.0 and use off the shelf Opto or Relay modules, no PCB required. Not recommended for Hi RF environments since the interconnecting wiring will act as antennas but likely OK for inside the shack usage.
2026-06-29 Filter Comm port list box to USB ports only. Improve related device lists and error messages.
    [pyRFPowerMeter.py]
2026-06-29 Spruce up Comm Port GUI formatting. Show LINUX /dev/tty devices in GUI listbox.
2026-06-29 Fix showing LINUX /dev/tty devices in GUI listbox.
    [pyRFPowerMeter.py]
2026-06-30 Revise README for decoder IP connection and GUI updates
    Updated README to reflect changes in band decoder functionality and improvements in the GUI for port selection, including support for Linux serial devices.
